connorwhite-online/grip/generative/README.md

# GRIP, redesigned generatively

Every structural link of the arm, grown from its joint layout by
[loadpath](https://github.com/connorwhite-online/loadpath), an open-source
topology optimization engine for printed parts, and sized together as one
chain. GRIP is loadpath's reference project: its CONTEXT.md describes how the
two are developed together.

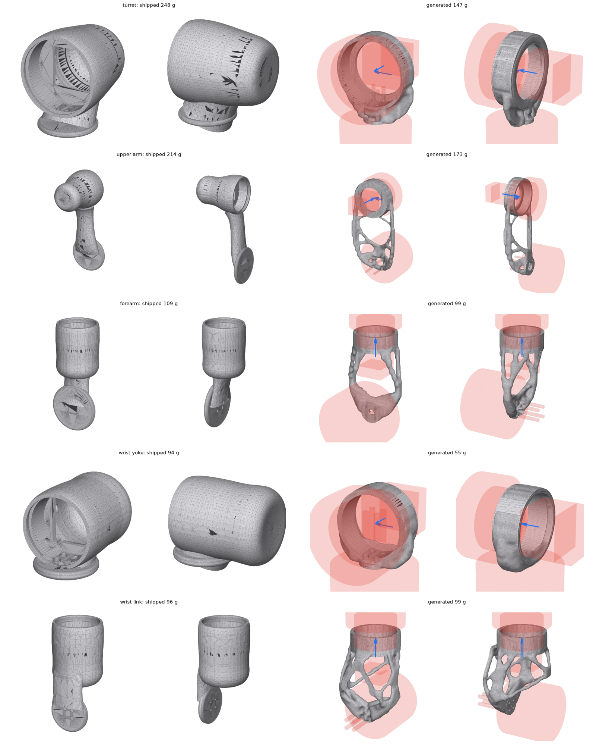
[picture p3: generative/renders/compare.png]
Shipped links (left) and generated links (right)


## What it does

`chain.py` reads the joint layout from `cad/grip_cad/params.py`. For each link it
writes a loadpath study with only the parts of the link that are not negotiable:

- **Preserved:** a bolt ring on the output flange of the joint below, and a socket
  for the drive of the joint above. The socket is a 5 mm sleeve round the housing
  plus the ledge its six M3 inserts sit in.
- **Kept out:** the drives, the motors and their CAN driver boards, the hex-driver
  access to every hub bolt, and room for the next link to swing.

Everything between the hub and the socket is the optimizer's.

Loads come from statics over `urdf/grip.urdf`. Each link carries everything past
it: the links, drives, gripper and a 1 kg payload, with the arm reaching out
horizontally and a 1.5x dynamic factor. Each link also sees the joint above
at its rated torque (the URDF effort), plus a 20 N push along that joint's axis.

The goal is a safety factor of 2 in SLS PA12-GF, as light as possible. After a
pass, the new link masses go back into the statics and the links are optimized
again.

```bash
pip install loadpath            # or put materialize/cad-runner on PYTHONPATH
python generative/chain.py studies                 # write studies/*.json
python generative/chain.py run --iterations 2      # optimize every link, feed masses back
python generative/chain.py report                  # shipped vs generated, same loads
```

## Results (two iterations)

Every part below was verified by a fresh FEA of the delivered mesh under the same
three load cases. Deflection is in mm at the joint above. SF is against 48 MPa,
with a 1.15 allowance.

| Link | Shipped | Generated | SF shipped → generated | Reach deflection | Rated-torque deflection | Side-push deflection |
| --- | --- | --- | --- | --- | --- | --- |
| Turret | 248 g | **147 g** | 1.37 → 1.44 | 0.82 → 0.73 | 0.93 → 0.82 | 0.25 → 0.09 |
| Upper arm | 214 g | **173 g** | 0.50 → 3.89 | 2.69 → 0.70 | 2.05 → 0.25 | 4.42 → 1.35 |
| Forearm | 109 g | **99 g** | 0.51 → 4.09 | 1.81 → 0.21 | 0.14 → 0.05 | 0.39 → 0.03 |
| Wrist yoke | 94 g | **55 g** | 2.33 → 2.73 | 0.50 → 0.32 | 0.25 → 0.16 | 0.03 → 0.03 |
| Wrist link | 96 g | 99 g | 0.48 → 3.42 | 0.75 → 0.17 | 0.95 → 0.11 | 0.94 → 0.16 |
| **Total** | **761 g** | **572 g (−25%)** | | | | |

Every generated link is stiffer than the shipped one in every load case, and
four of the five are lighter. The upper arm, forearm and wrist link go from
breaking at their joint's rated torque (SF ≈ 0.5) to safety factors of 3.4–4.1.

## What it does not change, yet

- **Joint torques barely move.** At J2 the static torque goes from 14.7 to
  14.5 N·m, because the printed links are a small share of what J2 carries:
  about 2.1 kg of motors, gearboxes, bearings and gripper, against about 0.5 kg
  of printed links past J2. Lighter links alone will not let J2 step down from the NEMA 23. That
  takes moving mass out of the wrist, for example by driving J4–J6 from the
  forearm or elbow through belts or cables. That is the next study: the
  structure is no longer the constraint.
- **The motor pods are gone.** The shipped links enclose each motor and
  driver; the generated ones only carry them. Covers would need to be added
  back as thin non-structural shells, about 10–20 g a link, if the
  protection or look matters.
- **Resolution.** These ran at about 3 mm voxels, so members are at least
  about 4.5 mm. Finer runs should take more off. The turret's safety factor
  of 1.44 is under the goal of 2 in the finer verification; the study's own
  check passed it at its resolution.
- **Assumptions to check against the real assembly:** the bolt ring size,
  the 5 mm socket sleeve, the swing clearances and the cable run. FDM parts
  would need a run with PETG and the build direction set.

Generated with loadpath's eval harness; the studies in `studies/` are plain JSON
and can be re-run or edited by hand or by an agent.

## v0.3: a cheaper arm, not just lighter links (`v3.py`)

The v0.2 links showed the structure was no longer the problem: J2 carries
about 2.1 kg of motors and gearboxes, so lighter plastic barely moved its torque.
`architecture.py` compares six layouts against that. v0.3 is option F:

- **J1–J3 stay steppers on printed cycloidal drives, all the same NEMA 17 drive.**
  The NEMA 23 at J2 goes.
- **A spring counterbalances J2.** A zero-free-length spring (cable over a
  pulley on the turret to a pin on the upper arm) cancels most of gravity's
  moment at every angle. J2 then needs 8.4 N·m against the drive's 13 N·m.
- **The wrist and gripper are serial bus servos** (Feetech STS3215/STS3250)
  instead of steppers, gearboxes and driver boards. That takes about 0.9 kg off
  the end of the arm, which is what made the J2 change possible.

Every link was then regenerated around the new hardware: servo cradles,
horn hubs and the spring's pulley, anchor and pin.

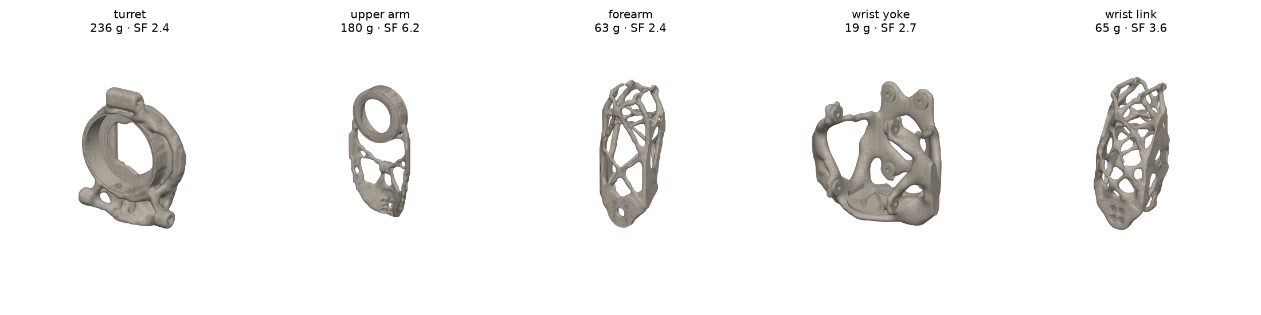
[picture p4: generative/renders/v3.png]
v0.3 links


| Link | Shipped | v0.2 | v0.3 | v0.3 SF |
| --- | --- | --- | --- | --- |
| Turret | 248 g | 147 g | 236 g | 2.41 |
| Upper arm | 214 g | 173 g | 179 g | 2.81 |
| Forearm | 109 g | 99 g | 63 g | 2.39 |
| Wrist yoke | 94 g | 55 g | 19 g | 2.70 |
| Wrist link | 96 g | 99 g | 65 g | 3.55 |
| **Total** | **761 g** | **572 g** | **562 g (-26%)** | |

The turret gains mass because it now carries the spring's pulley and anchor, and because it is now checked on a finer grid (it read SF 2.26 at 60k cells and 1.65 at 120k before).
On the parts that change, the BOM drops about $16 (≈ $209 → $193): one NEMA 23
and its driver, and three stepper/gearbox/driver sets at the wrist, against
three bus servos, a servo driver board, a spring and a pulley.

```bash
python generative/v3.py studies     # write v3/studies/*.json
python generative/v3.py run --jobs 3
```

Open items before printing:

- **Servo dimensions and shaft offsets are marked VERIFY in `v3.py`**; they are
  from datasheets, not calipers.
- **J5 torque:** the STS3250 is rated about 1.6 N·m continuous; J5 needs about
  1.7 N·m at a 1 kg payload at full reach. It is fine for 0.5 kg; at 1 kg it is
  a peak, not a continuous, load.
- **Servo holders** are fixed only where the servo is held: a collar round the
  body at the horn end (where its ears screw down) and a pad under the far end.
  The walls between are generated. (A full 3 mm box was most of the wrist yoke.)
- The spring rate and anchor geometry (k = 1 N/mm, a = 62 mm, b = 80 mm) are
  sized for the arm at rest. Check them against the assembled arm's real mass.

### Simulations

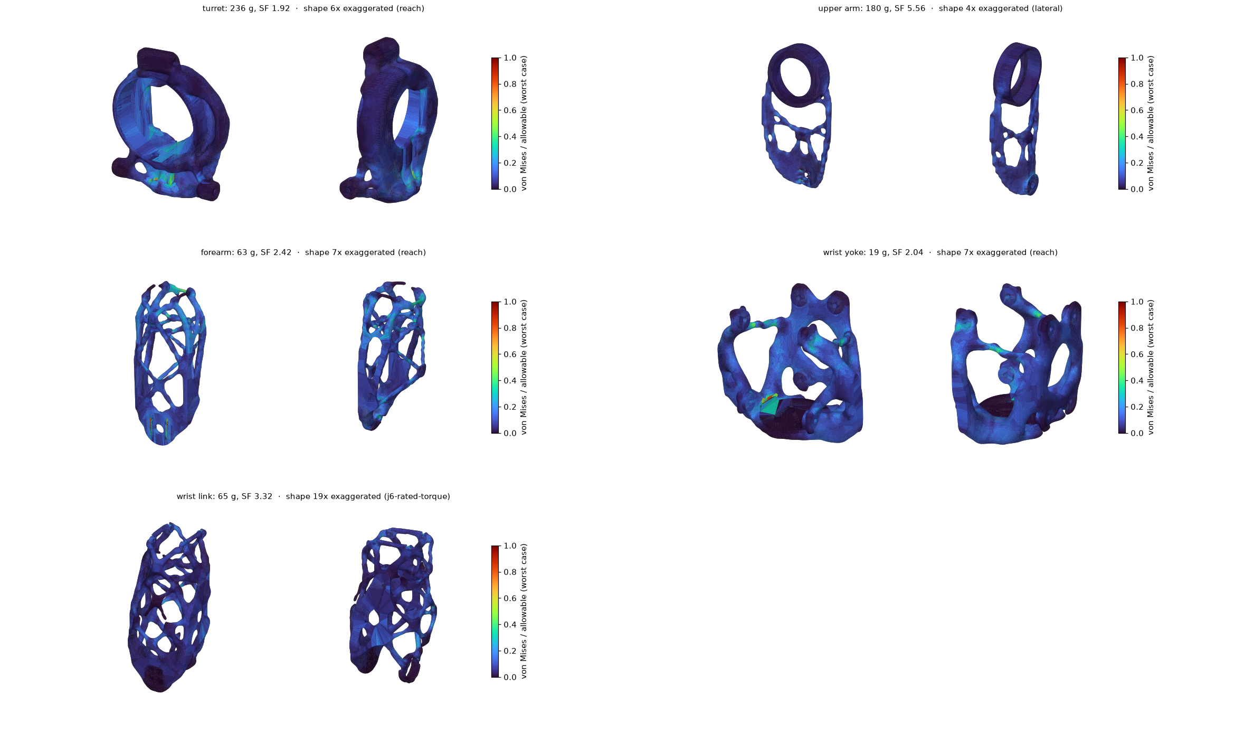
[picture p5: generative/renders/sims.png]
Stress maps


`sims.py` re-checks each delivered part on a finer grid (120k cells) and
colours it by the worst case's stress over the allowable at SF 2, on the shape
deflected and exaggerated. Results are in `v3/out/sims.json`.

| Link | SF (finer check) | Worst deflection |
| --- | --- | --- |
| Turret | 1.92 | 0.54 mm (reach) |
| Upper arm | 5.56 | 1.55 mm (lateral) |
| Forearm | 2.42 | 0.45 mm (reach) |
| Wrist yoke | 2.04 | 0.14 mm (reach) |
| Wrist link | 3.32 | 0.20 mm (reach) |

Every search now re-checks its pick on a 150k-cell grid before delivering it
(loadpath's confirm stage), and material carrying no load is pruned. The
checks on different grids still differ by about ±20% at small fillets: the
turret reads 2.41 at 150k cells and 1.92 here.
## The hand (`hand.py`)

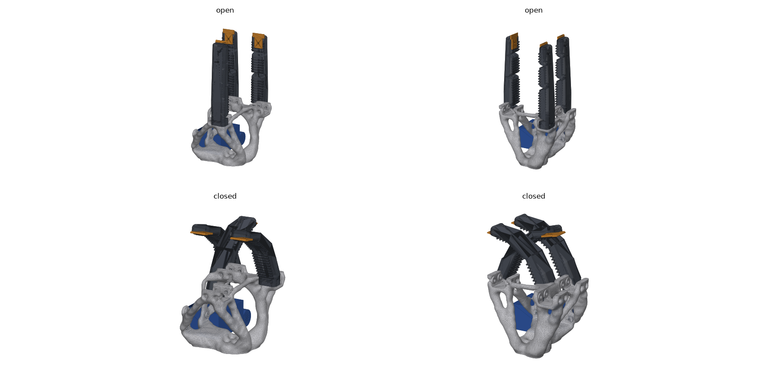
[picture p6: generative/renders/hand.png]
Three-finger hand, open and closed


Three soft fingers on one servo replace the parallel-jaw gripper and its
two Ø6 rods, four LM6UU bearings, rack, pinion and set screws.

- **Fingers:** one TPU print each (20 g): three phalanges on flexure hinges,
  a tendon channel, ridged pads, tapered and rounded. About 17 N of tendon
  closes them; the rest is grip.
- **One servo, one tendon, a balance plate:** the STS3215 winds a spool; a
  floating three-way plate splits the pull so each finger stops when it
  touches and the others keep closing.
- **Optional fingernails** for flat parts on a print bed: a PA12 blade with a
  15 mm tongue down the last phalanx, seated on a shoulder (scraping pushes
  it in) and held by an M2 screw through the finger (prying and pull-out).
- **Palm:** generated, 56 g, SF 3.2 under the grasp, a 1 kg pull-out, a side
  load, and the tendon at half the servo's stall torque.

Grip force at 60 N of tendon (1.4 N·m on the servo) is about 4 to 28 N per
finger, depending on where the part touches. The servo reports its load, so
the arm can grip by force without a sensor. All of it is a first concept:
VERIFY the flexure thickness on a printed coupon, the servo, and the tendon
routing.

### Can the optimizer design the finger? (`finger_mechanism.py`, experimental)

A finger has to bend, so it is a compliant-mechanism problem, not a
stiffness one; loadpath gained a mechanism optimizer for it
(`loadpath.mechanism`, Sigmund's formulation with MMA). Two framings so far:

- **Tendon curl** (maximize the pad's inward travel when the tendon pulls)
  comes out as a single leaf spring: the honest optimum of that question, and
  not a useful finger.
- **Fin-ray wrap** (an object pressing the middle of the palm face should
  swing the tip in toward it) needs a deep root to lever with. At 28 mm it
  finds the fin ray's principle, a strut leaning from the back of the root
  up to the palm skin, but only one rib of it.

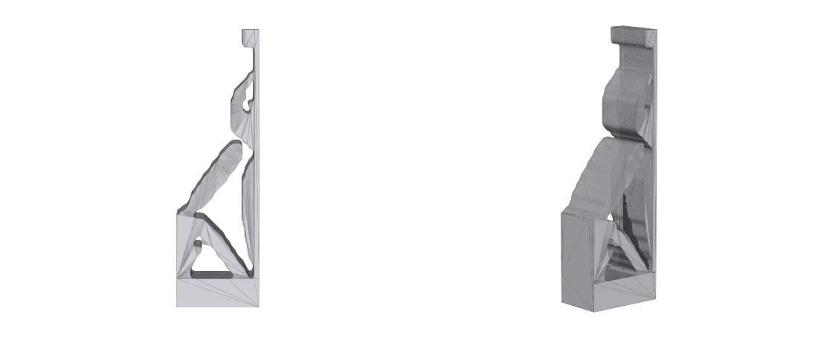
[picture p7: generative/renders/finger-wrap.png]
Fin-ray wrap, first result


Next: contact anywhere along the finger (several input cases at once, which
is what makes a real fin ray grow its ladder of ribs), and large-deflection
checks. Until then the hinged finger in `hand.py` is the design.
