connorwhite-online/grip/docs/img/exploded_j2.png

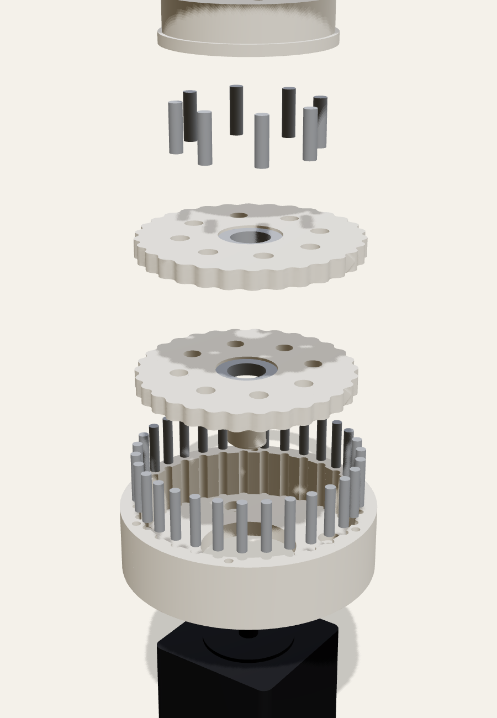
docs/img/exploded_j2.png
