connorwhite-online/grip/docs/img/exploded_wrist.png

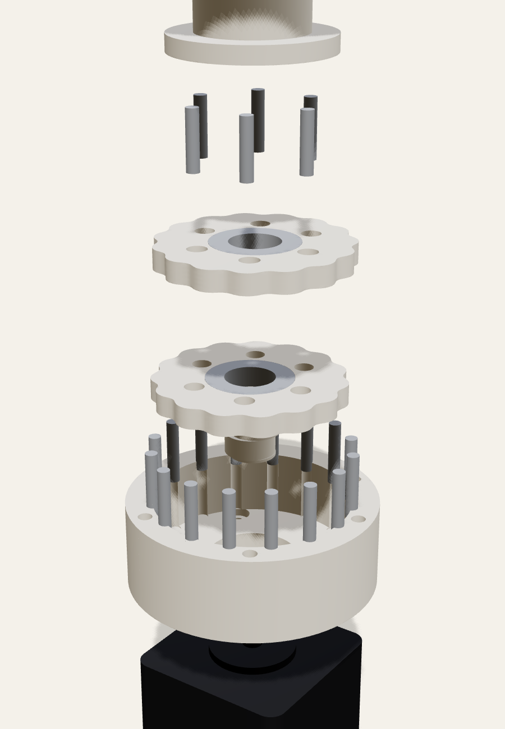
docs/img/exploded_wrist.png
