connorwhite-online/grip/docs/img/home_front.png

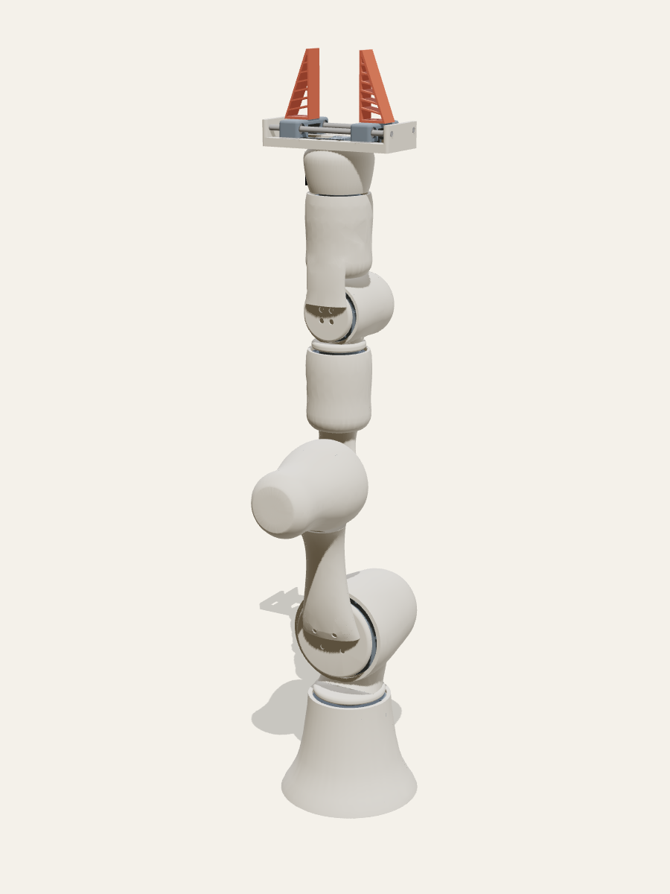
docs/img/home_front.png
