connorwhite-online/grip/docs/img/home_side.png

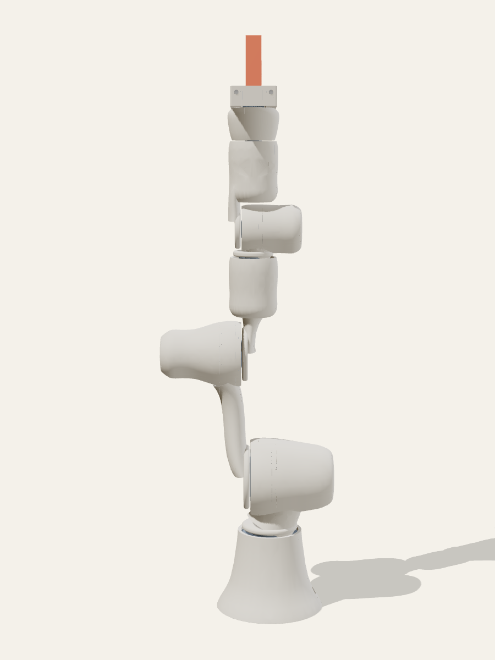
docs/img/home_side.png
