connorwhite-online/grip/docs/img/reach_pose.png

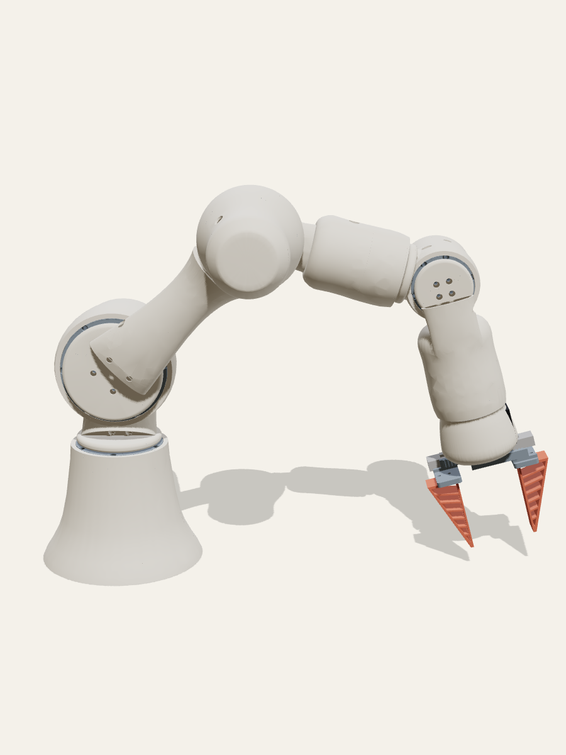
docs/img/reach_pose.png
