connorwhite-online/grip/generative/renders/sim-forearm.png

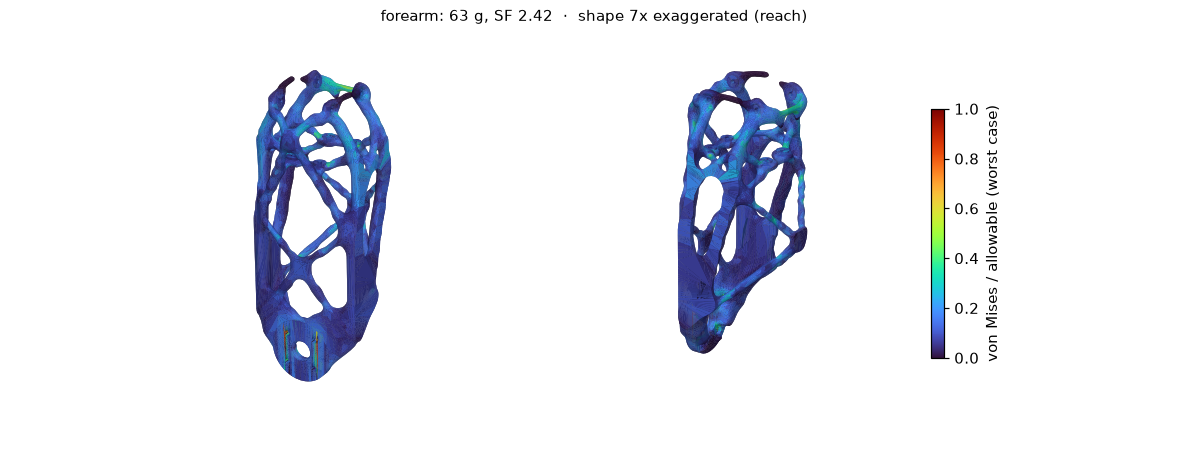
generative/renders/sim-forearm.png
