connorwhite-online/grip/generative/renders/sim-turret.png

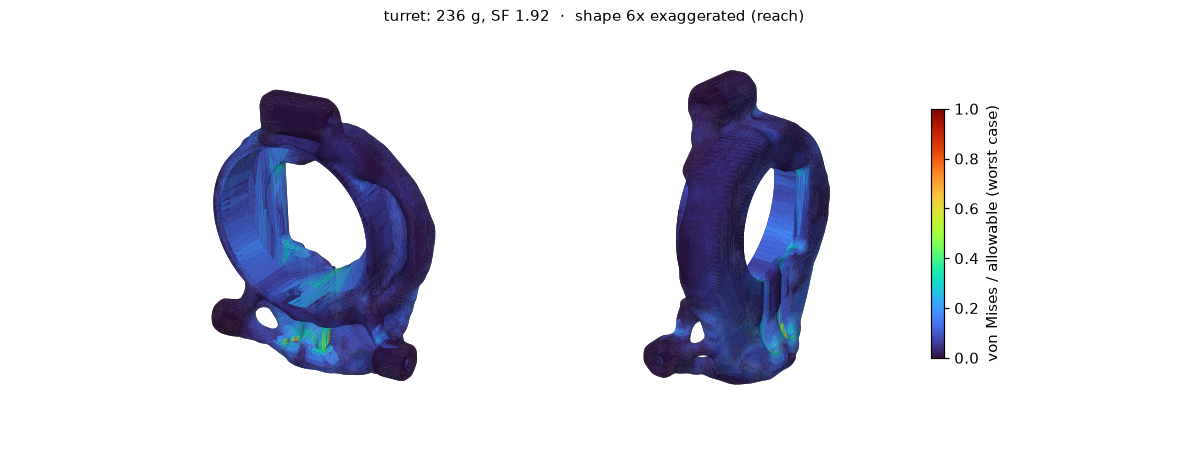
generative/renders/sim-turret.png
