connorwhite-online/grip/generative/renders/sim-wrist_yoke.png

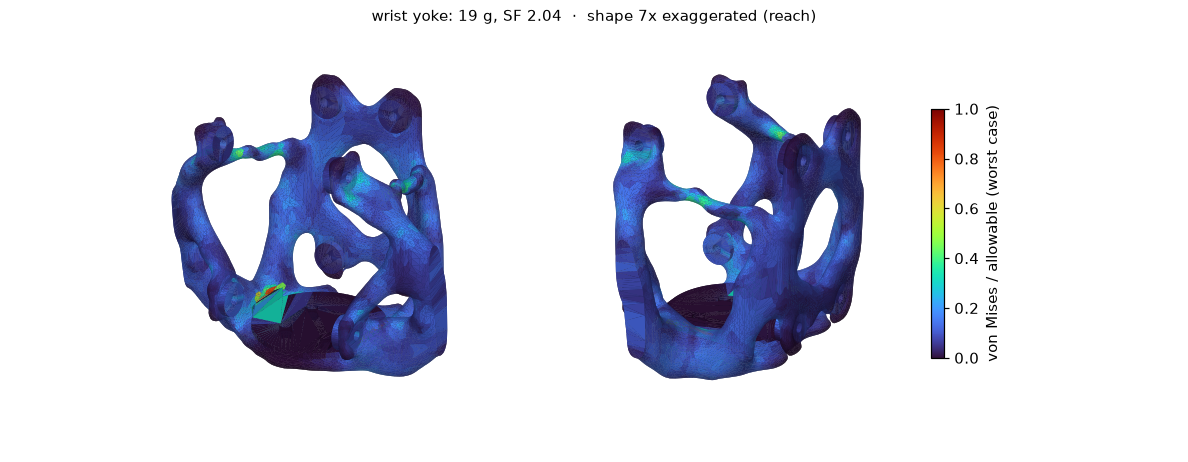
generative/renders/sim-wrist_yoke.png
