connorwhite-online/grip/bom/BOM.md

# GRIP bill of materials

Bought parts for version B; the same list serves both the SLS and the FDM edition. Prices marked *estimate* could not be read from the store page (Amazon and AliExpress block automated reads); check them when ordering. Printed parts are listed after.

## Motion

| Item | Spec | Qty | Unit (USD) | Line (USD) | Price | Buy |
| --- | --- | ---: | ---: | ---: | --- | --- |
| Stepper J2 shoulder | NEMA 23, 1.26 Nm, 56 mm, dual shaft Ø8 (23HS22-2804D) | 1 | 17.68 | 17.68 | checked 2026-10-27 | [StepperOnline](https://www.omc-stepperonline.com/dual-shaft-nema-23-bipolar-126nm-1784ozin-28a-25v-57x57x56mm-4-wires-23hs22-2804d.html) |
| Stepper J1 base + J3 elbow | NEMA 17, 0.65 Nm, 60 mm, dual shaft Ø5 (17HS24-2104D) | 2 | 13.05 | 26.10 | checked 2026-10-27 | [StepperOnline](https://www.omc-stepperonline.com/Dual-Shaft-Nema-17-Bipolar-18deg-65Ncm-923ozin-210A-336V-42x42x60mm-4-Wires.html) |
| Stepper J4-J6 wrist | NEMA 17, 0.26 Nm, 34 mm, dual shaft Ø5 (17HS13-0404D) | 3 | 8.75 | 26.25 | checked 2026-10-27 | [StepperOnline](https://www.omc-stepperonline.com/dual-shaft-nema-17-bipolar-1-8deg-26ncm-36-8oz-in-0-4a-12v-42x34mm-4-wires-17hs13-0404d) |
| Closed-loop driver NEMA 17 | MKS SERVO42D, CAN version (magnet on rear shaft) | 5 | 28.00 | 140.00 | estimate | [Makerbase (AliExpress)](https://www.aliexpress.com/item/1005005593922187.html) |
| Closed-loop driver NEMA 23 | MKS SERVO57D, CAN version | 1 | 40.00 | 40.00 | estimate | [Makerbase (AliExpress)](https://www.aliexpress.com/item/1005005389508166.html) |

Subtotal: **$250.03**

## Gripper

| Item | Spec | Qty | Unit (USD) | Line (USD) | Price | Buy |
| --- | --- | ---: | ---: | ---: | --- | --- |
| Gripper servo | Feetech STS3215, 12 V, 30 kg·cm, magnetic encoder | 1 | 29.00 | 29.00 | checked 2026-10-27 (EUR 26.51) | [OpenELAB](https://openelab.io/collections/feetech-motor) |
| Bus servo adapter | Waveshare Bus Servo Adapter (A), USB to TTL bus | 1 | 4.99 | 4.99 | checked 2026-10-27 | [Waveshare](https://www.waveshare.com/bus-servo-adapter-a.htm) |
| Guide rods | Ø6 x 150 mm hardened linear shaft (2) | 1 | 8.00 | 8.00 | estimate | [Amazon](https://www.amazon.com/s?k=6mm+x+150mm+linear+shaft) |
| Linear bearings | LM6UU, Ø6 x 12 x 19 (4 used, pack of 10) | 1 | 7.00 | 7.00 | estimate | [Amazon](https://www.amazon.com/s?k=lm6uu+linear+bearing+10+pack) |

Subtotal: **$48.99**

## Gearbox

| Item | Spec | Qty | Unit (USD) | Line (USD) | Price | Buy |
| --- | --- | ---: | ---: | ---: | --- | --- |
| Output bearing J2 | 6812-2RS, 60x78x10 (uxcell) | 1 | 11.49 | 11.49 | checked 2026-10-27 | [Walmart](https://www.walmart.com/ip/Uxcell-60x78x10mm-6812-2RS-Double-Sealed-Ball-Bearings-Chrome-Steel/867130943) |
| Output bearing J1/J3 | 6808-2RS, 40x52x7 | 2 | 9.99 | 19.98 | checked 2026-10-27 | [Walmart](https://www.walmart.com/ip/6808-2RS-Deep-Groove-Ball-Bearing-40x52x7mm-Double-Sealed-Chrome-Steel-Bearing/631340571) |
| Output bearing wrist | 6805-2RS, 25x37x7 (generic pack of 4-5; 3 used) | 1 | 14.00 | 14.00 | estimate (VXB singles $7.77 checked) | [Amazon](https://www.amazon.com/s?k=6805-2rs+bearing) |
| Eccentric bearing J2 | 6802-2RS, 15x24x5 (generic 10-pack; 2 used) | 1 | 9.00 | 9.00 | estimate (VXB singles $7.77 checked) | [Amazon](https://www.amazon.com/s?k=6802-2rs+bearing+10+pack) |
| Eccentric bearing J1/J3/wrist | 6801-2RS, 12x21x5 (generic 10-pack; 10 used) | 1 | 10.00 | 10.00 | estimate (VXB 10-pack $29.99 checked) | [Amazon](https://www.amazon.com/s?k=6801-2rs+bearing+10+pack) |
| Ring pins J1/J2/J3 | Dowel pin Ø4 x 20 mm, steel (83 needed) | 90 | 0.12 | 10.80 | estimate | [Amazon (uxcell packs)](https://www.amazon.com/stainless-steel-dowel-pins/s?k=stainless+steel+dowel+pins+4mm+x+20mm) |
| Ring pins wrist | Dowel pin Ø3 x 16 mm, steel (48 needed) | 50 | 0.10 | 5.00 | estimate | [Amazon (uxcell packs)](https://www.amazon.com/stainless-steel-dowel-pins/s?k=stainless+steel+dowel+pins+3mm+x+16mm) |
| Output pins J2 | Dowel pin Ø5 x 18 mm, steel | 8 | 0.20 | 1.60 | estimate | [Amazon (uxcell packs)](https://www.amazon.com/stainless-steel-dowel-pins/s?k=stainless+steel+dowel+pins+5mm+x+18mm) |
| Output pins J1/J3 | Dowel pin Ø4 x 16 mm, steel | 12 | 0.12 | 1.44 | estimate | [Amazon (uxcell packs)](https://www.amazon.com/stainless-steel-dowel-pins/s?k=stainless+steel+dowel+pins+4mm+x+16mm) |
| Output pins wrist | Dowel pin Ø3 x 14 mm, steel | 18 | 0.10 | 1.80 | estimate | [Amazon (uxcell packs)](https://www.amazon.com/stainless-steel-dowel-pins/s?k=stainless+steel+dowel+pins+3mm+x+14mm) |

Subtotal: **$85.11**

## Fasteners

| Item | Spec | Qty | Unit (USD) | Line (USD) | Price | Buy |
| --- | --- | ---: | ---: | ---: | --- | --- |
| Heat-set inserts | M3 x 5.7 brass (pack of 100; 66 used), plus 3x M5 | 1 | 12.00 | 12.00 | estimate | [Amazon](https://www.amazon.com/s?k=m3+heat+set+inserts) |
| Socket head screws | M3x8 (24) for the link hubs, plus gearbox through-bolts M3x40 (6), M3x35 (12), M3x30 (18) | 1 | 18.00 | 18.00 | estimate | [Amazon](https://www.amazon.com/s?k=m3+socket+head+screw+assortment) |
| Motor screws | Low-head DIN 7984: M3x8 (20) for the NEMA 17s, M5x16 + M5 nyloc nut (4) for the NEMA 23 | 1 | 8.00 | 8.00 | estimate | [Amazon](https://www.amazon.com/s?k=din+7984+m3+low+head+socket+screw) |
| Base and gripper screws | M5x20 (3) base to table; M3x12 (4) gripper frame to palm; M3x10 + nyloc (4) fingers; M3x6 set screw (4) guide rods; M3x12 (2) camera cradle; M2x5 self-tapping (4) camera board | 1 | 7.00 | 7.00 | estimate | [Amazon](https://www.amazon.com/s?k=m2+socket+head+screw+assortment) |

Subtotal: **$45.00**

## Electronics

| Item | Spec | Qty | Unit (USD) | Line (USD) | Price | Buy |
| --- | --- | ---: | ---: | ---: | --- | --- |
| USB to CAN adapter | CANable 2.0 clone (candleLight firmware, SocketCAN) | 1 | 15.00 | 15.00 | estimate | [AliExpress](https://www.aliexpress.com/w/wholesale-canable-2.0.html) |
| Power supply | 24 V 10 A enclosed switching supply (generic; Mean Well LRS-250-24 if you want the name brand) | 1 | 20.00 | 20.00 | estimate | [Amazon](https://www.amazon.com/s?k=24v+10a+switching+power+supply) |
| Buck converter | 24 V to 12 V 5 A for the gripper servo | 1 | 6.00 | 6.00 | estimate | [Amazon](https://www.amazon.com/s?k=24v+to+12v+5a+buck+converter) |
| Emergency stop | Latching mushroom e-stop, NC, cuts motor power | 1 | 7.00 | 7.00 | estimate | [Amazon](https://www.amazon.com/s?k=emergency+stop+button+latching) |
| Wiring | 20 AWG silicone wire (22 AWG from J4 up), twisted pair for CAN, XT30 connectors, inline fuse | 1 | 15.00 | 15.00 | estimate | [Amazon](https://www.amazon.com/s?k=20+awg+silicone+wire) |

Subtotal: **$63.00**

## Vision

| Item | Spec | Qty | Unit (USD) | Line (USD) | Price | Buy |
| --- | --- | ---: | ---: | ---: | --- | --- |
| Wrist camera | Arducam UB0234: OV2710 1080p USB 2.0 UVC board, 32 x 32 mm, M12 lens 105 deg horizontal | 1 | 34.99 | 34.99 | checked 2026-10-27 | [Arducam](https://www.arducam.com/arducam-2mp-wide-angle-usb2-0-camera-board-with-m12-lens-1-2-7-cmos-ov2710-uvc-usb-webcam-without-microphone-for-computer-laptop-android-devi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) |
| Camera cable | Slim USB 2.0 cable, 2 m, 3 mm OD or less (spliced to the camera's lead, see docs/VISION.md) | 1 | 6.00 | 6.00 | estimate | [Amazon](https://www.amazon.com/s?k=slim+thin+usb+2.0+cable+2m) |
| Camera light | 5 V white LED strip, 2835, 60 LED/m, 8 mm wide (two 2-LED pieces beside the lens) | 1 | 6.00 | 6.00 | estimate | [Amazon](https://www.amazon.com/s?k=5v+usb+led+strip+2835+white+8mm) |
| Fiducial markers | AprilTag tag36h11 printed on matte sticker paper (id 0 on the bed; id 1 optional), plus a ChArUco board for camera calibration | 1 | 0.00 | 0.00 | print yourself | [AprilRobotics](https://github.com/AprilRobotics/apriltag-imgs) |

Subtotal: **$46.99**

**Bought parts total: $539.12**

## Printed parts

30 unique parts, 50 pieces, 1,620 cm³ in total. Full list with materials in [exports/printed_parts.csv](../exports/printed_parts.csv); bureau stacked kits in [exports/service_kits.csv](../exports/service_kits.csv).

## Printed parts, FDM edition

Filament for one arm, before supports and failed prints (allow about 15% more). Per-part list in [exports/fdm/printed_parts.csv](../exports/fdm/printed_parts.csv); settings in [docs/FDM.md](../docs/FDM.md).

| Material | Filament |
| --- | ---: |
| FDM PETG | 1.79 kg |
| FDM PETG-CF (or PA-CF) | 0.31 kg |
| FDM TPU 95A | 0.03 kg |
