connorwhite-online/grip/exports/service_kits.csv

kit | qty | material | volume_cm3 | bbox_x_mm | bbox_y_mm | bbox_z_mm | stl
kit_j2_drive | 1 | SLS PA12 | 214.8 | 102.0 | 102.0 | 94.0 | stl/kits/kit_j2_drive.stl
kit_j1_j3_drive | 2 | SLS PA12 | 128.1 | 86.0 | 86.0 | 80.5 | stl/kits/kit_j1_j3_drive.stl
kit_wrist_drive | 3 | SLS PA12 | 57.9 | 61.0 | 61.0 | 74.5 | stl/kits/kit_wrist_drive.stl
kit_gripper | 1 | SLS PA12 | 32.8 | 76.5 | 65.0 | 64.0 | stl/kits/kit_gripper.stl
kit_fingers | 1 | SLS TPU 90A-95A | 21.5 | 30.0 | 22.0 | 146.0 | stl/kits/kit_fingers.stl
