connorwhite-online/grip/exports/step/grip_assembly.step

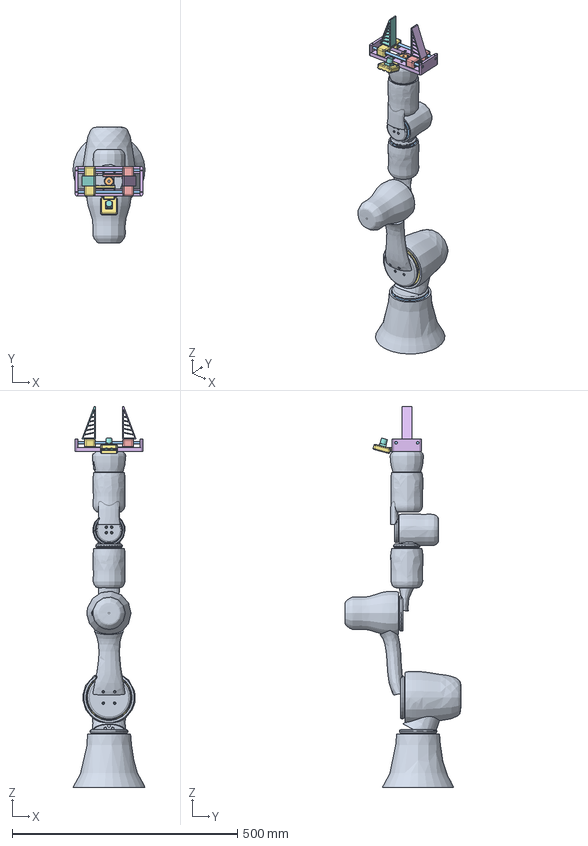
[picture p16: CAD file, 2026-10-28]
exports/step/grip_assembly.step
160.0 x 257.3 x 846.0 mm
base
turret
upper_arm
forearm
wrist_yoke
wrist_link
j1_housing
j1_cap
j1_output_flange
j1_motor
j2_housing
j2_cap
j2_output_flange
j2_motor
j3_housing
j3_cap
j3_output_flange
j3_motor
j4_housing
j4_cap
j4_output_flange
j4_motor
j5_housing
j5_cap
j5_output_flange
j5_motor
j6_housing
j6_cap
j6_output_flange
j6_motor
gripper_palm
gripper_frame
gripper_camera_mount
gripper_camera
gripper_servo
gripper_pinion
gripper_rod_b
gripper_rod_a
gripper_bearings_a
gripper_jaw_a
gripper_finger_a
gripper_bearings_b
gripper_jaw_b
gripper_finger_b
