connorwhite-online/grip/exports/fdm/step/turret.step

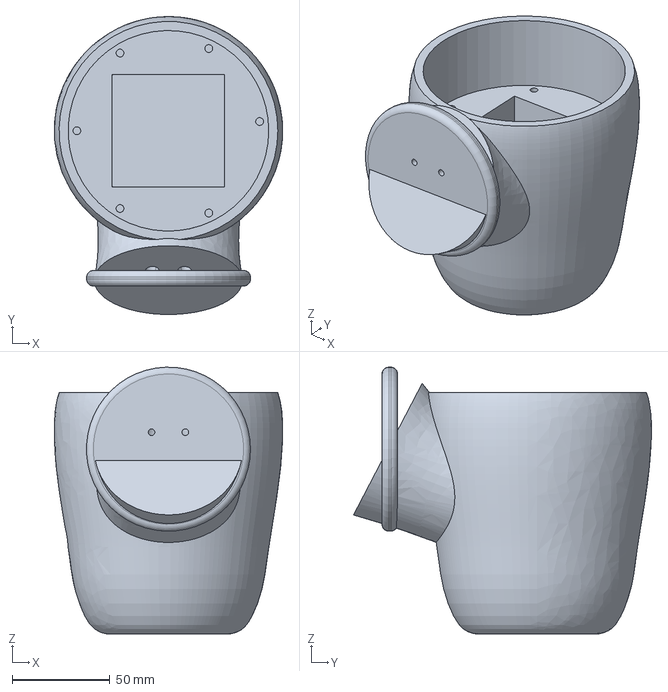
[picture p17: CAD file, 2026-10-28]
exports/fdm/step/turret.step
116.9 x 152.6 x 136.6 mm
