connorwhite-online/grip/exports/step/wrist_drive_eccentric.step

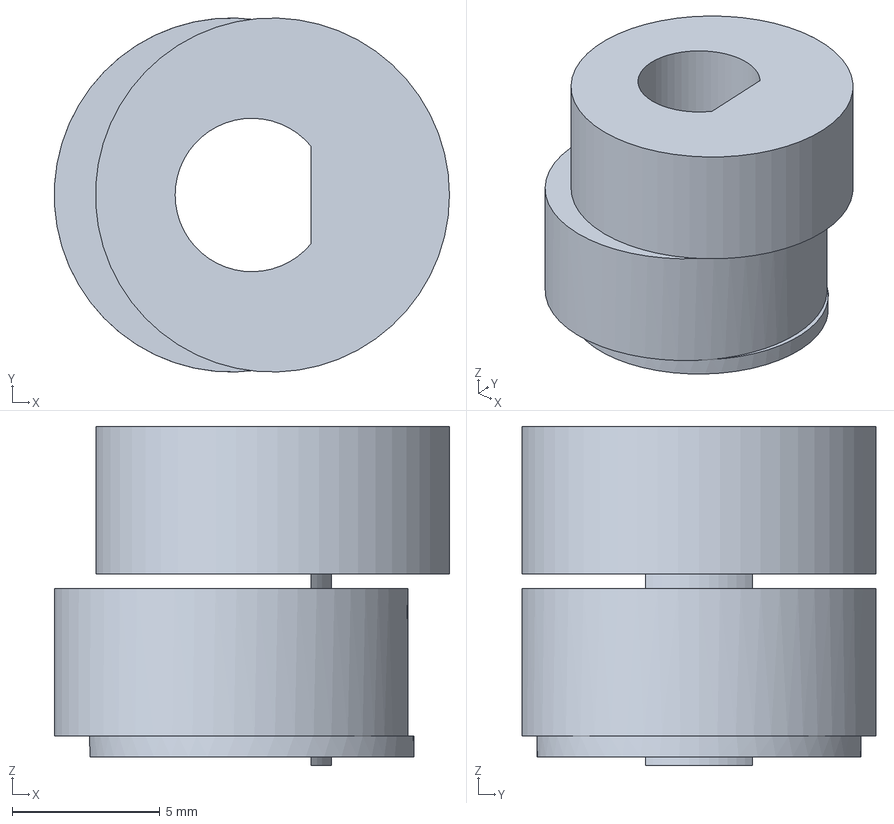
[picture p18: CAD file, 2026-10-28]
exports/step/wrist_drive_eccentric.step
13.4 x 12.0 x 11.5 mm
