connorwhite-online/grip/exports/stl/kits/kit_gripper.stl

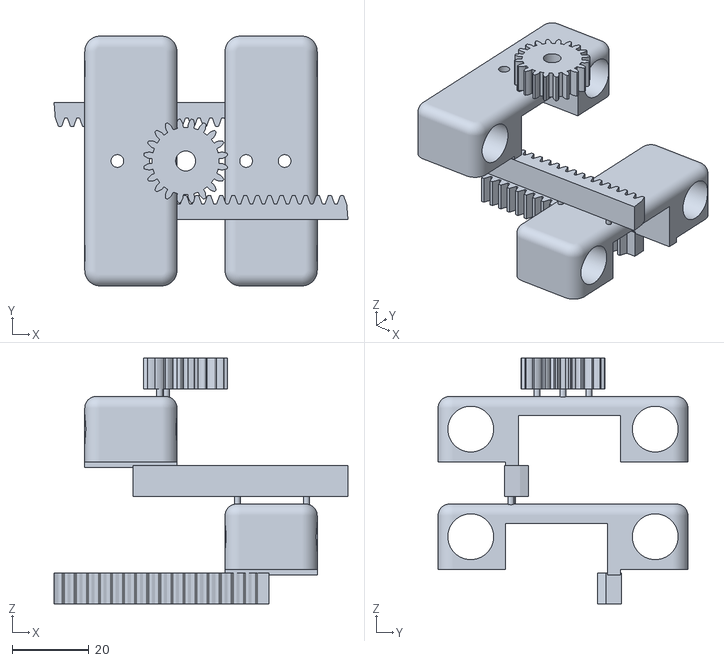
[picture p19: CAD file, 2026-10-27]
exports/stl/kits/kit_gripper.stl
76.5 x 65.0 x 64.0
