connorwhite-online/grip/generative/hand/finger-mech.stl

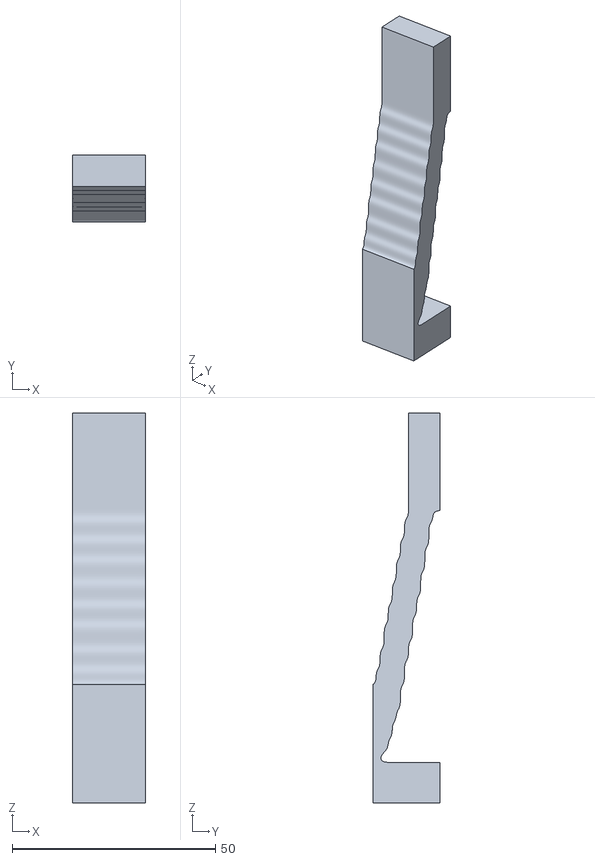
[picture p20: CAD file, 2026-10-29]
generative/hand/finger-mech.stl
18.0 x 16.5 x 96.0
