connorwhite-online/grip/generative/out/wrist_link.stl

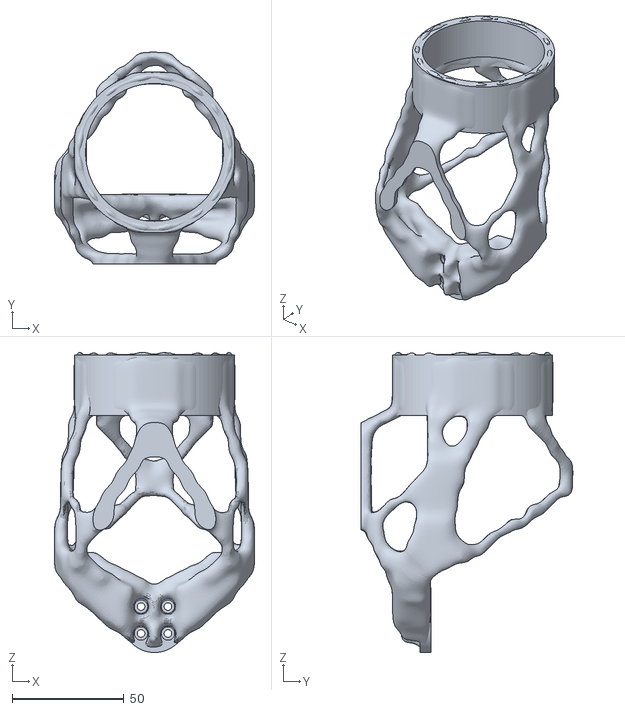
[picture p21: CAD file, 2026-10-29]
generative/out/wrist_link.stl
89.5 x 94.6 x 134.1
