connorwhite-online/grip/generative/print/grip-wrist-yoke-PETG-FDM-v3.stl

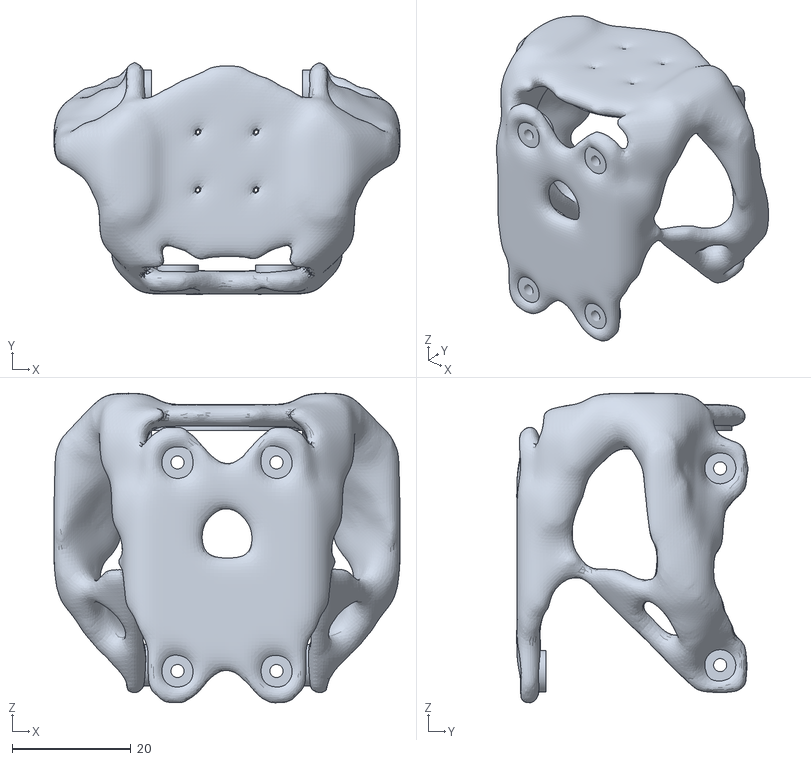
[picture p22: CAD file, 2026-10-29]
generative/print/grip-wrist-yoke-PETG-FDM-v3.stl
58.4 x 39.1 x 52.2
