connorwhite-online/grip/generative/v3/out/turret.stl

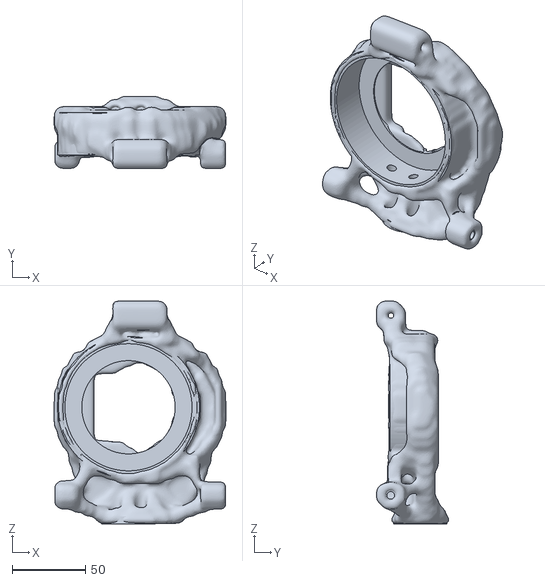
[picture p23: CAD file, 2026-10-29]
generative/v3/out/turret.stl
116.9 x 49.2 x 151.9
