connorwhite-online/grip/urdf/meshes/tool.stl

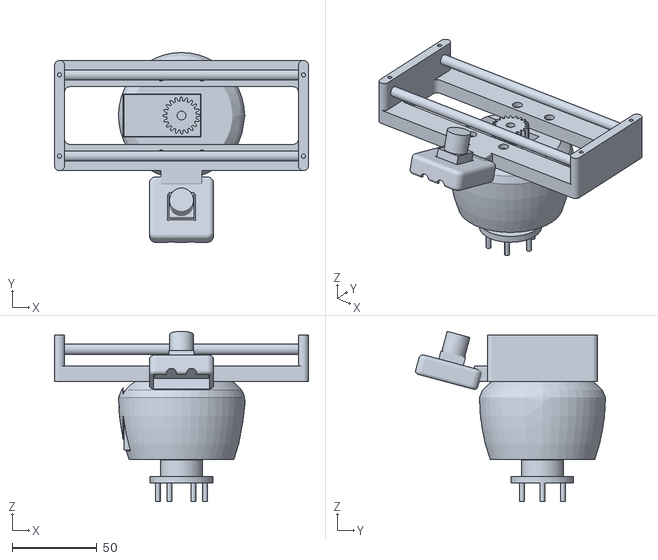
[picture p24: CAD file, 2026-10-28]
urdf/meshes/tool.stl
150.0 x 112.2 x 100.6
