connorwhite-online/grip/exports/fdm/step/j1_j3_drive_output_flange.step

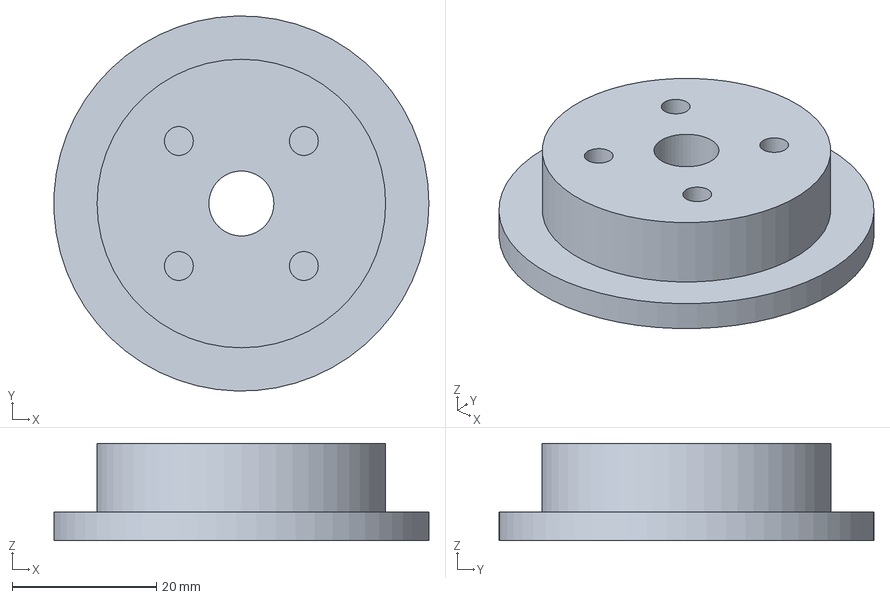
[picture p25: CAD file, 2026-10-28]
exports/fdm/step/j1_j3_drive_output_flange.step
52.0 x 52.0 x 13.5 mm
