connorwhite-online/grip/exports/step/j2_drive_disc_a.step

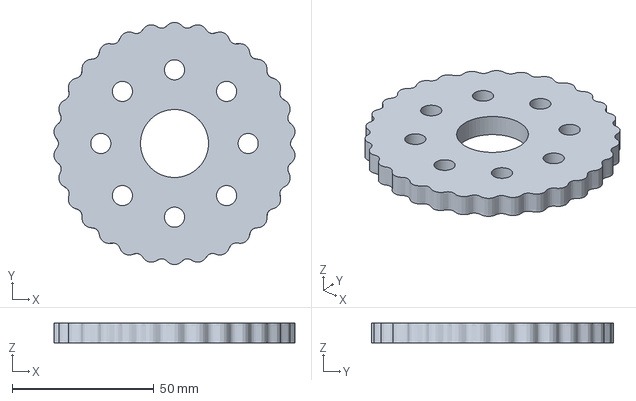
[picture p26: CAD file, 2026-10-28]
exports/step/j2_drive_disc_a.step
85.1 x 85.5 x 7.00 mm
