connorwhite-online/grip/exports/stl/kits/kit_j1_j3_drive.stl

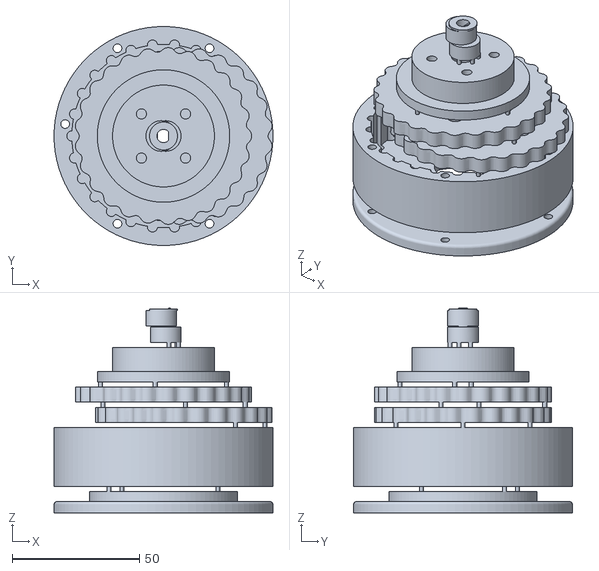
[picture p27: CAD file, 2026-10-27]
exports/stl/kits/kit_j1_j3_drive.stl
86.0 x 86.0 x 80.5
