connorwhite-online/grip/generative/hand/finger.stl

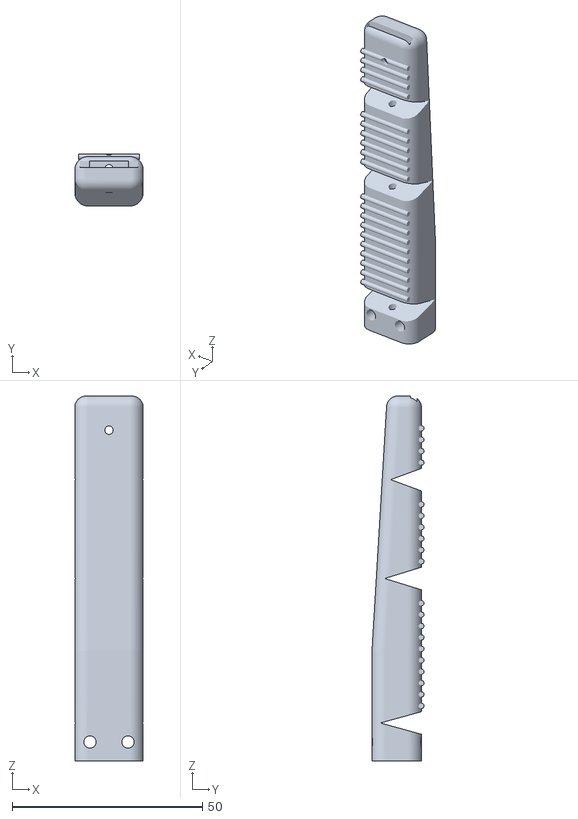
[picture p28: CAD file, 2026-10-29]
generative/hand/finger.stl
18.0 x 13.7 x 96.0
