connorwhite-online/grip/generative/out/upper_arm.stl

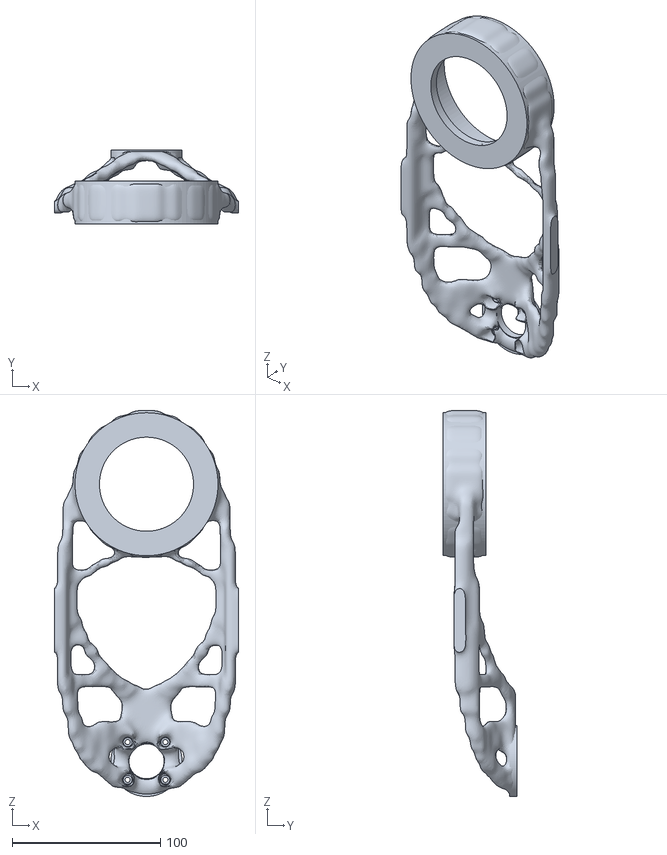
[picture p29: CAD file, 2026-10-29]
generative/out/upper_arm.stl
124.6 x 50.0 x 260.8
