connorwhite-online/grip/generative/v3/out/forearm.stl

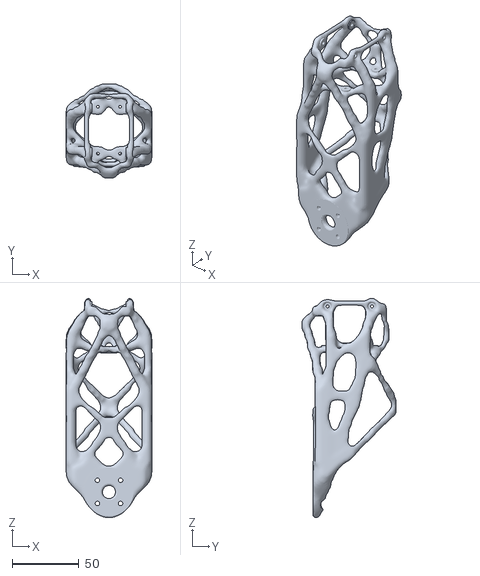
[picture p30: CAD file, 2026-10-29]
generative/v3/out/forearm.stl
64.2 x 70.7 x 164.1
