connorwhite-online/grip/urdf/meshes/forearm.stl

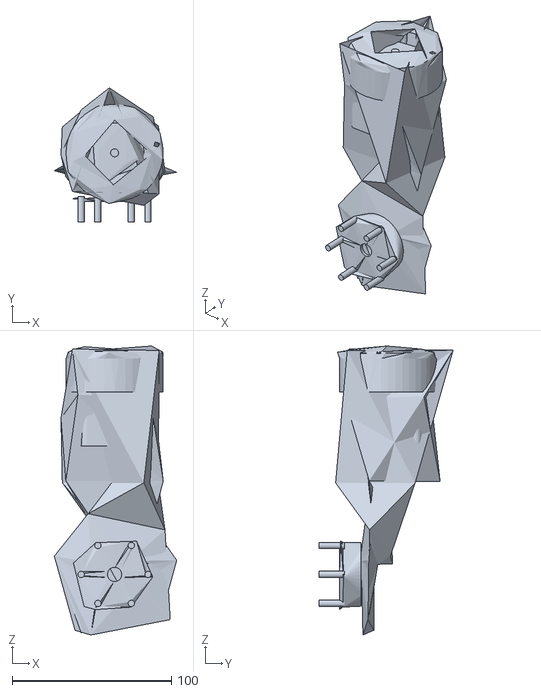
[picture p31: CAD file, 2026-10-27]
urdf/meshes/forearm.stl
76.8 x 84.3 x 181.5
