connorwhite-online/grip/exports/fdm/step/wrist_drive_housing.step

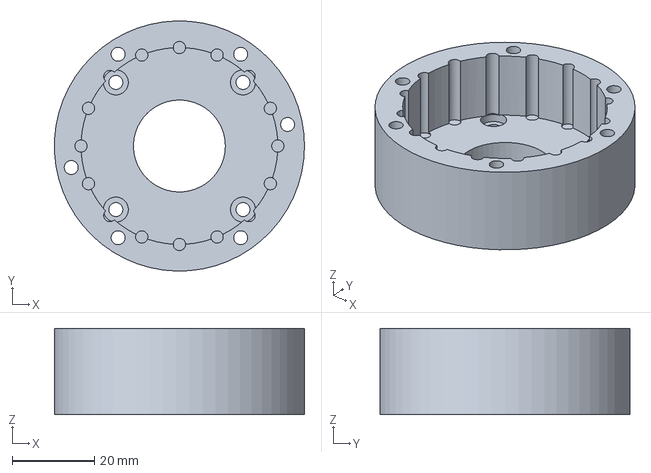
[picture p32: CAD file, 2026-10-28]
exports/fdm/step/wrist_drive_housing.step
61.0 x 61.0 x 21.0 mm
