connorwhite-online/grip/exports/step/j2_drive_output_flange.step

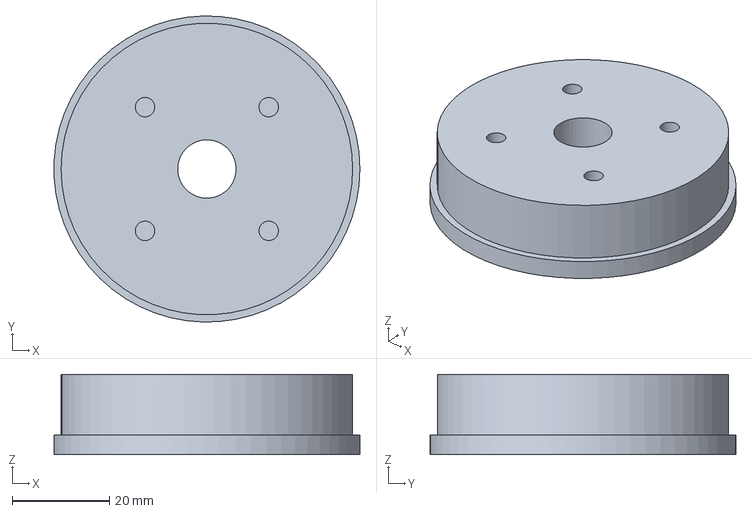
[picture p33: CAD file, 2026-10-28]
exports/step/j2_drive_output_flange.step
63.0 x 63.0 x 16.5 mm
