connorwhite-online/grip/exports/stl/kits/kit_j2_drive.stl

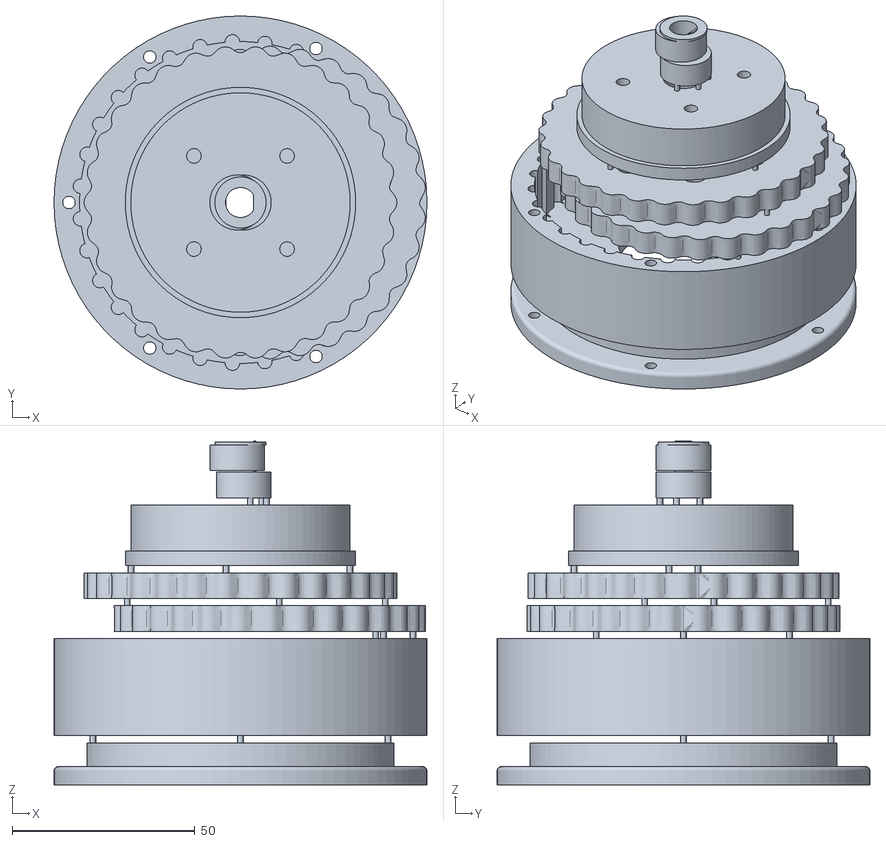
[picture p34: CAD file, 2026-10-27]
exports/stl/kits/kit_j2_drive.stl
102.0 x 102.0 x 94.0
