connorwhite-online/grip/generative/hand/nail.stl

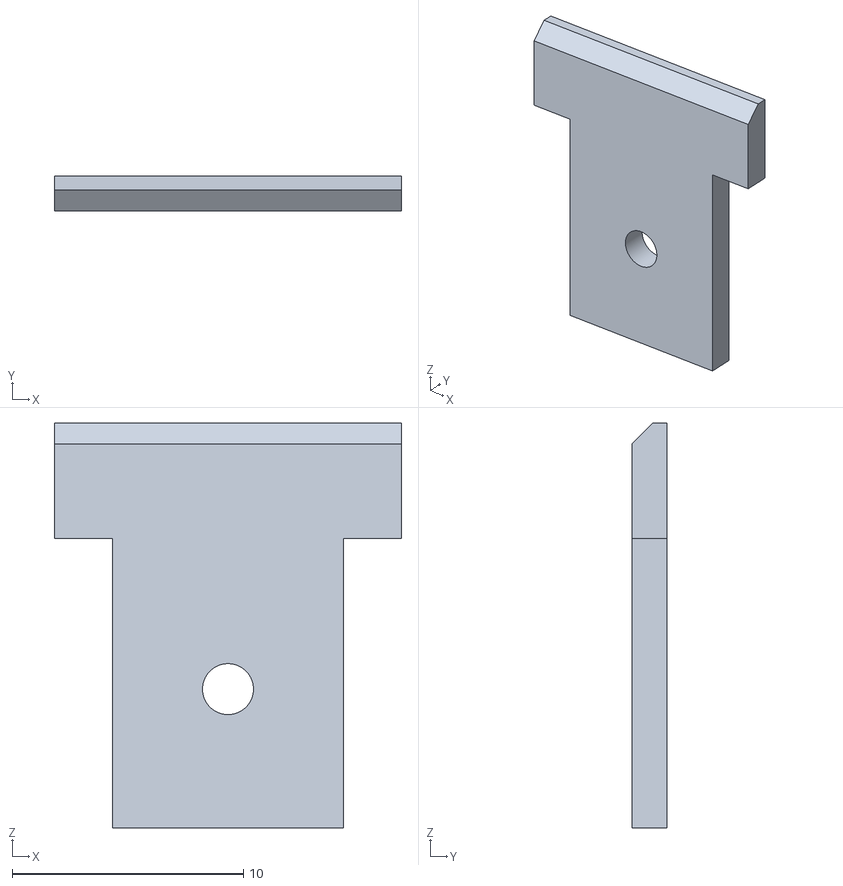
[picture p35: CAD file, 2026-10-29]
generative/hand/nail.stl
15.0 x 1.50 x 17.5
