connorwhite-online/grip/generative/out/turret.stl

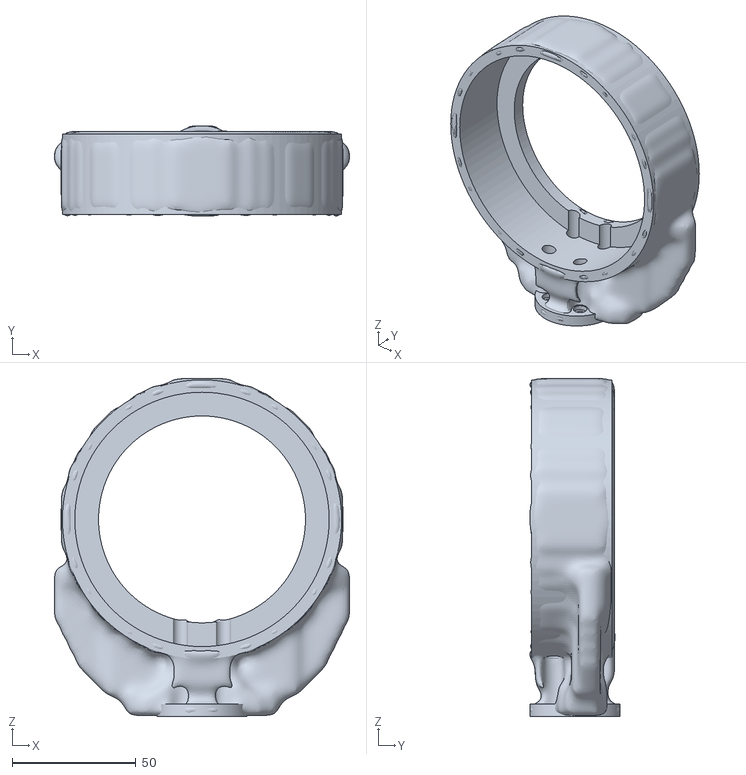
[picture p36: CAD file, 2026-10-29]
generative/out/turret.stl
119.0 x 36.5 x 136.3
