connorwhite-online/grip/generative/v3/out/wrist_yoke.stl

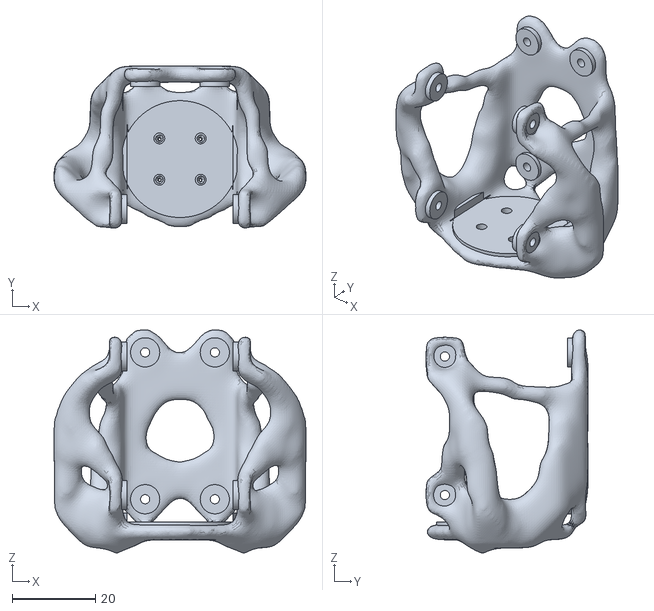
[picture p37: CAD file, 2026-10-29]
generative/v3/out/wrist_yoke.stl
60.4 x 38.8 x 53.4
