connorwhite-online/grip/urdf/meshes/jaw_a.stl

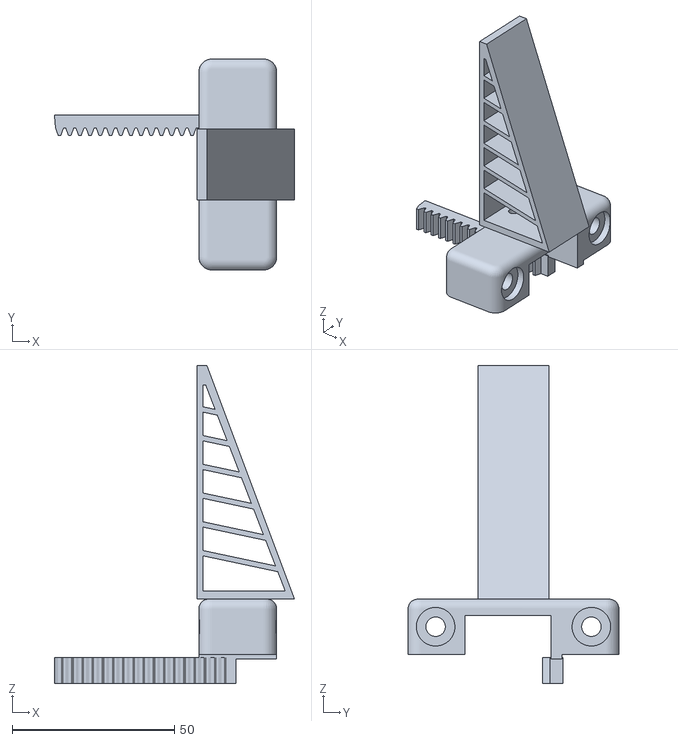
[picture p38: CAD file, 2026-10-27]
urdf/meshes/jaw_a.stl
74.0 x 65.0 x 98.0
