connorwhite-online/grip/exports/fdm/step/j1_j3_drive_eccentric.step

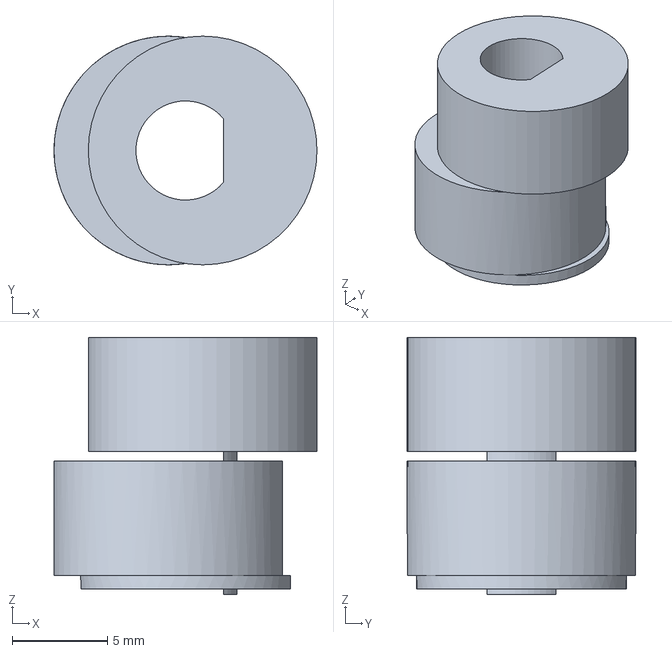
[picture p39: CAD file, 2026-10-28]
exports/fdm/step/j1_j3_drive_eccentric.step
13.8 x 12.0 x 13.5 mm
