connorwhite-online/grip/exports/stl/kits/kit_wrist_drive.stl

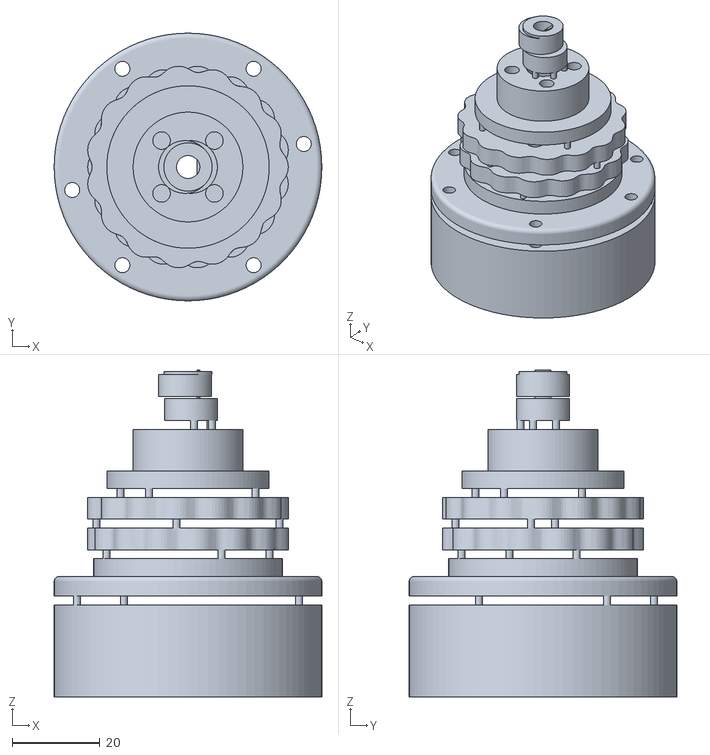
[picture p40: CAD file, 2026-10-27]
exports/stl/kits/kit_wrist_drive.stl
61.0 x 61.0 x 74.5
