connorwhite-online/grip/generative/hand/finger-wrap.stl

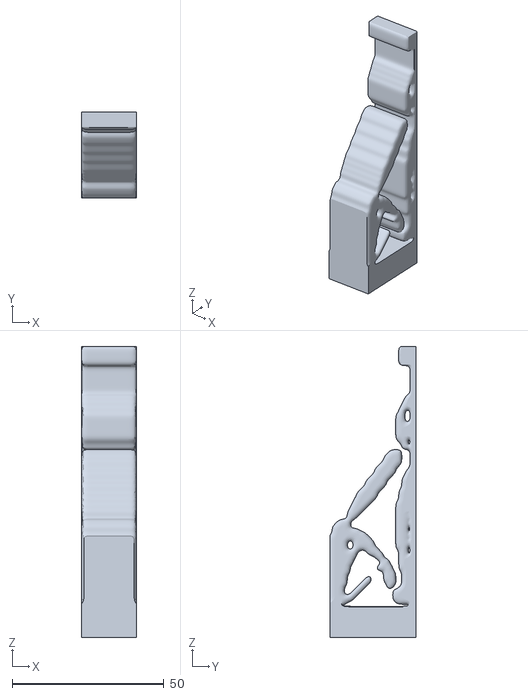
[picture p41: CAD file, 2026-10-29]
generative/hand/finger-wrap.stl
18.0 x 28.5 x 96.0
