connorwhite-online/grip/generative/out/forearm.stl

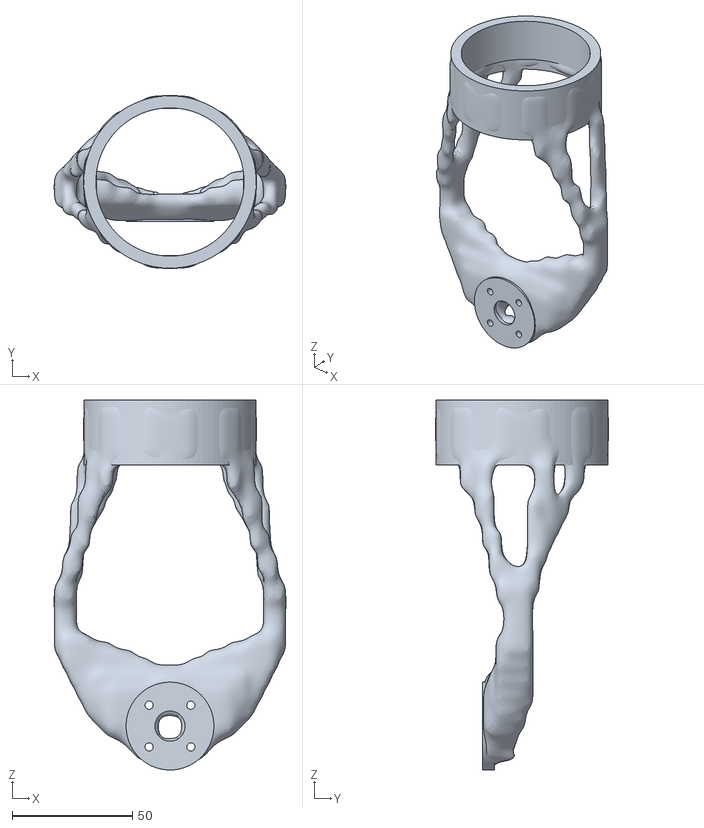
[picture p42: CAD file, 2026-10-29]
generative/out/forearm.stl
96.2 x 71.8 x 153.8
