connorwhite-online/grip/generative/v3/out/wrist_link.stl

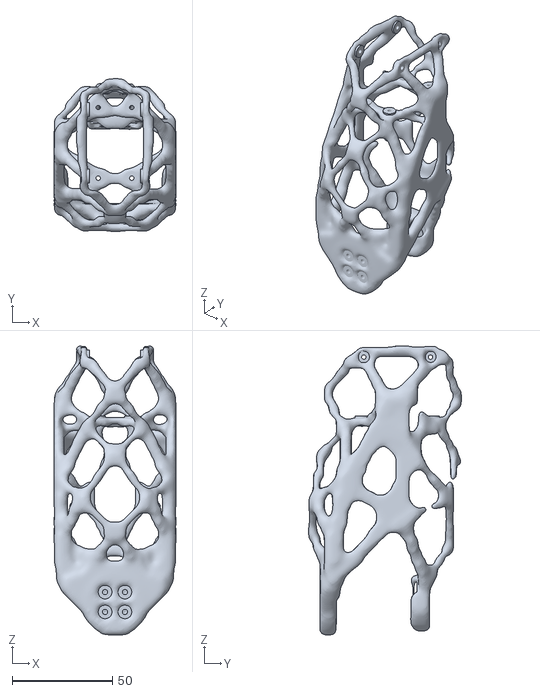
[picture p43: CAD file, 2026-10-29]
generative/v3/out/wrist_link.stl
60.6 x 76.1 x 144.0
