connorwhite-online/grip/urdf/meshes/upper_arm.stl

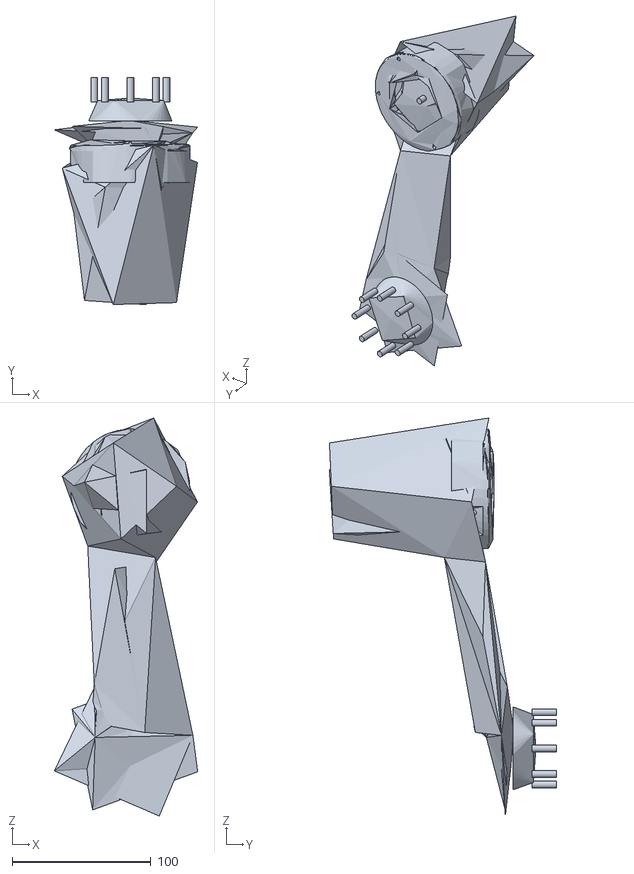
[picture p44: CAD file, 2026-10-27]
urdf/meshes/upper_arm.stl
103.3 x 164.0 x 286.9
