connorwhite-online/grip/exports/fdm/step/j1_j3_drive_housing.step

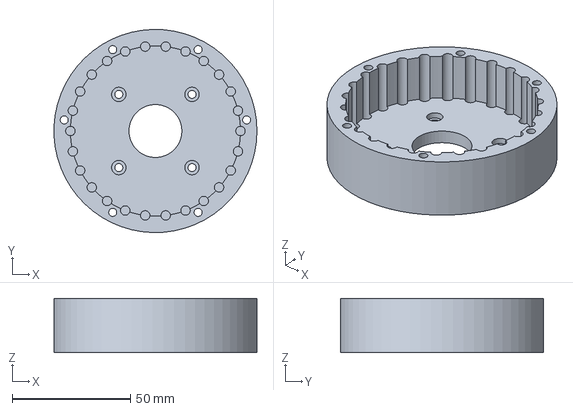
[picture p45: CAD file, 2026-10-28]
exports/fdm/step/j1_j3_drive_housing.step
85.9 x 86.0 x 23.0 mm
