connorwhite-online/grip/exports/stl/kits/kit_fingers.stl

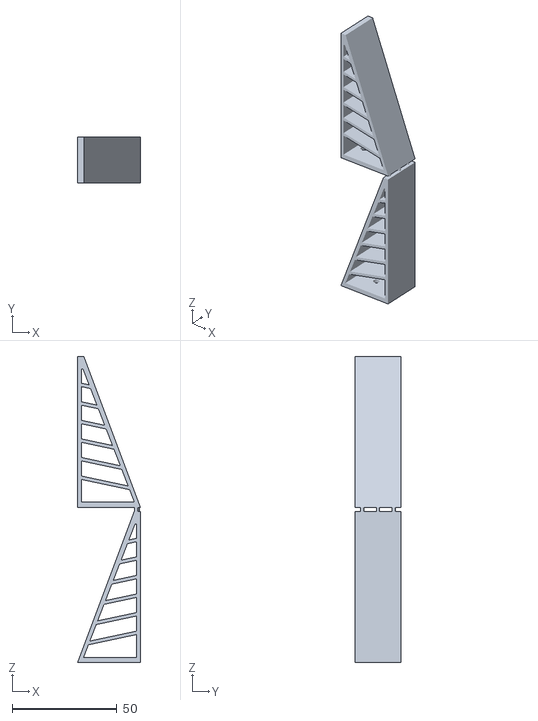
[picture p46: CAD file, 2026-10-27]
exports/stl/kits/kit_fingers.stl
30.0 x 22.0 x 146.0
