connorwhite-online/grip/generative/hand/palm.stl

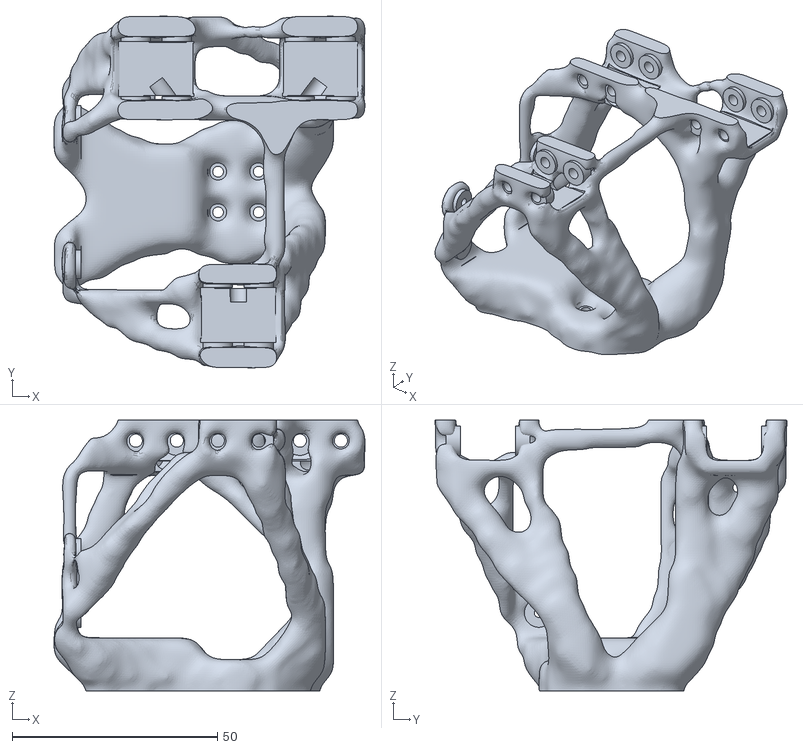
[picture p47: CAD file, 2026-10-29]
generative/hand/palm.stl
75.8 x 85.7 x 66.0
