connorwhite-online/grip/generative/out/wrist_yoke.stl

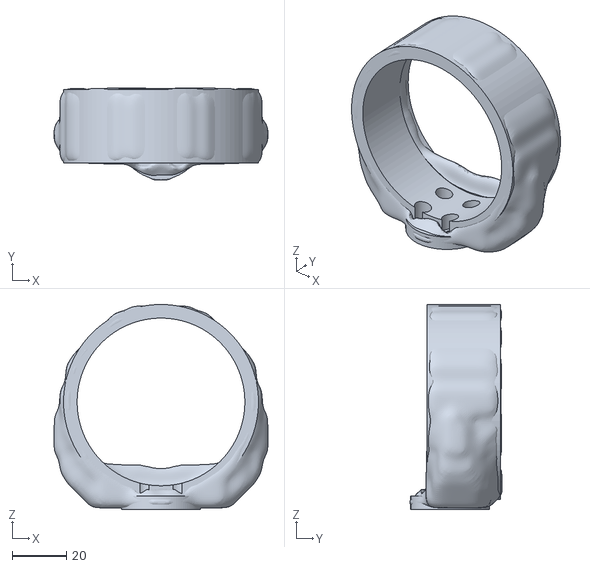
[picture p48: CAD file, 2026-10-29]
generative/out/wrist_yoke.stl
78.6 x 33.9 x 75.3
