connorwhite-online/grip/generative/v3/out/upper_arm.stl

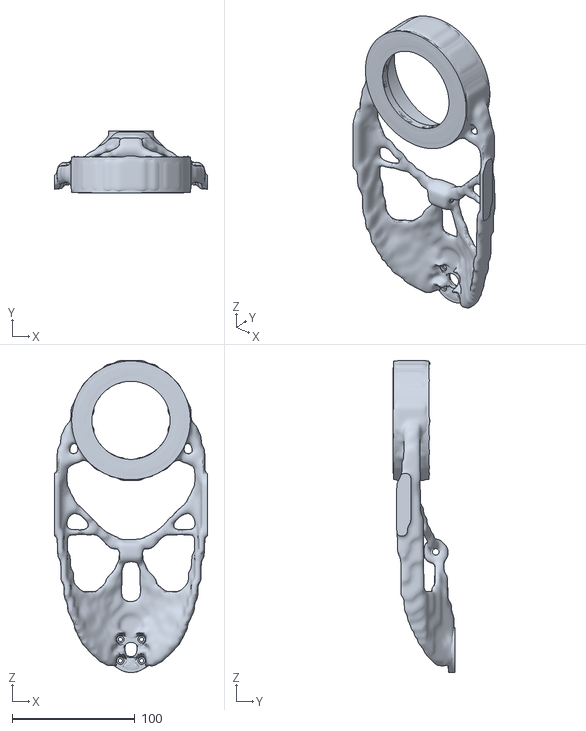
[picture p49: CAD file, 2026-10-29]
generative/v3/out/upper_arm.stl
124.6 x 50.1 x 253.9
