connorwhite-online/grip/urdf/meshes/wrist_link.stl

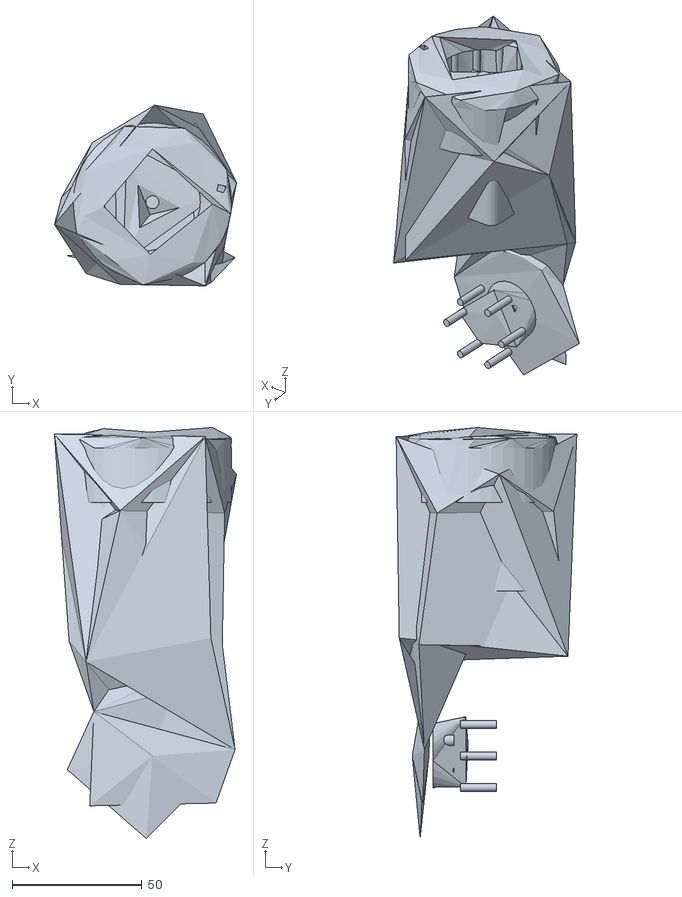
[picture p50: CAD file, 2026-10-27]
urdf/meshes/wrist_link.stl
70.1 x 69.6 x 158.2
