connorwhite-online/grip/exports/fdm/step/wrist_drive_disc_a.step

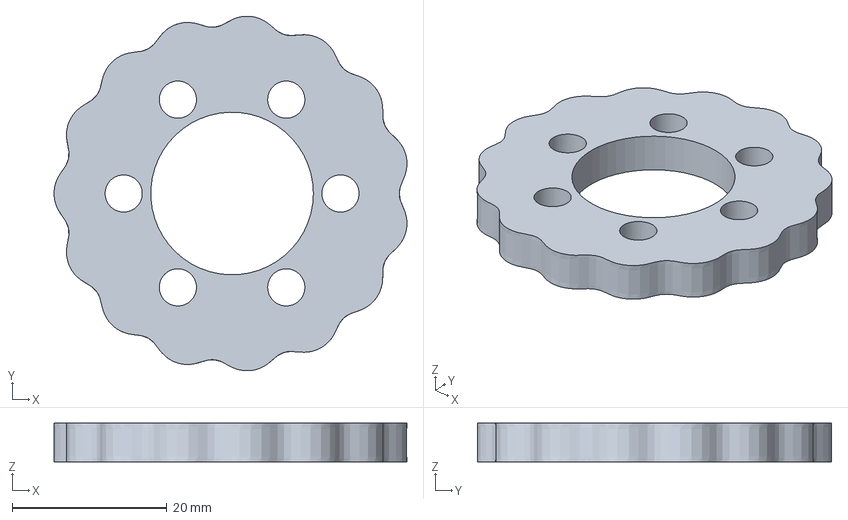
[picture p51: CAD file, 2026-10-28]
exports/fdm/step/wrist_drive_disc_a.step
45.6 x 45.8 x 5.00 mm
