connorwhite-online/grip/exports/step/j2_drive_eccentric.step

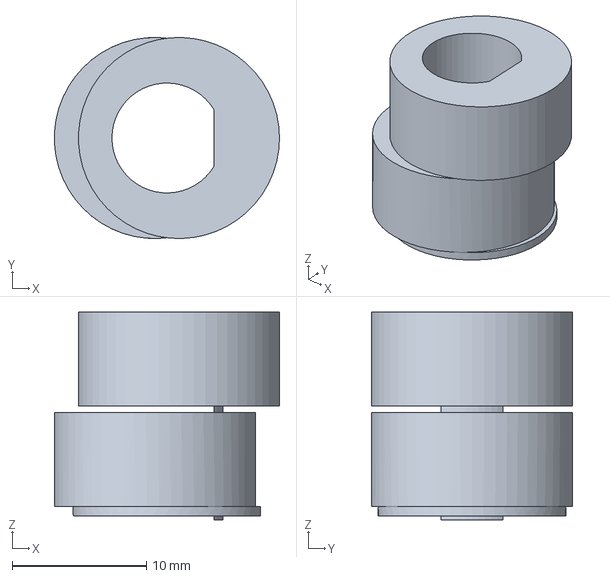
[picture p52: CAD file, 2026-10-28]
exports/step/j2_drive_eccentric.step
16.8 x 15.0 x 15.5 mm
