connorwhite-online/grip/urdf/meshes/base_link.stl

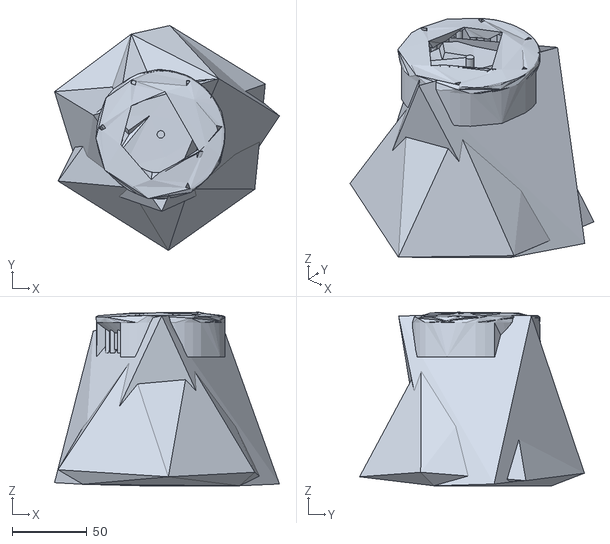
[picture p53: CAD file, 2026-10-27]
urdf/meshes/base_link.stl
150.5 x 150.4 x 116.1
