connorwhite-online/grip/exports/fdm/step/base.step

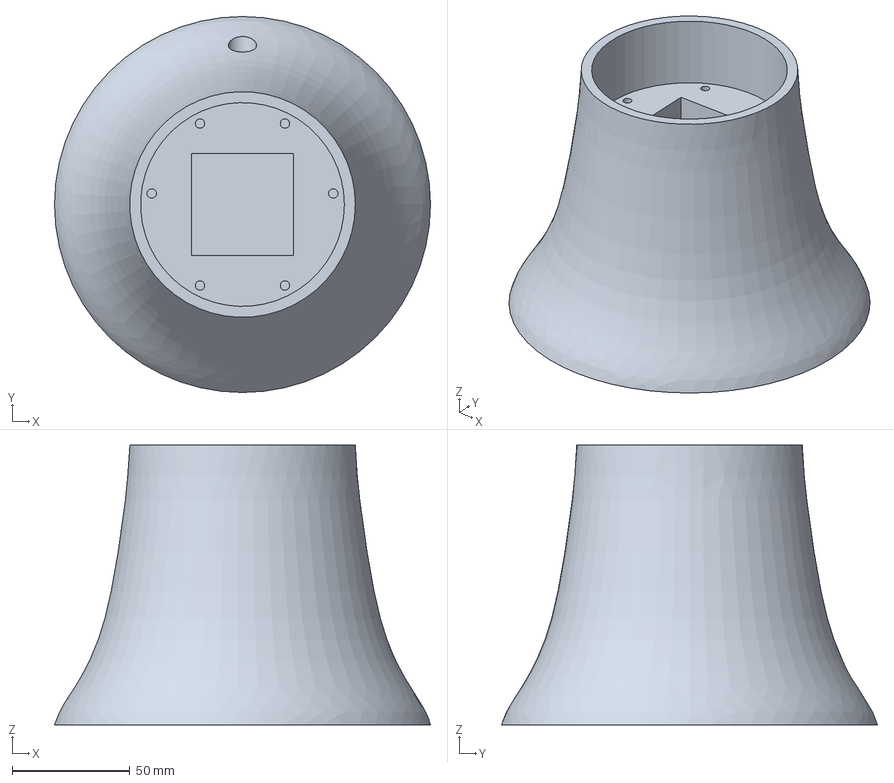
[picture p54: CAD file, 2026-10-28]
exports/fdm/step/base.step
160.0 x 160.0 x 119.0 mm
