connorwhite-online/grip/exports/step/gripper_finger.step

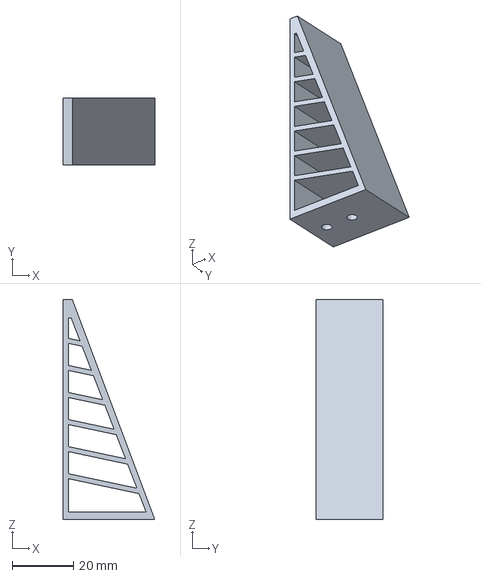
[picture p55: CAD file, 2026-10-28]
exports/step/gripper_finger.step
30.0 x 22.0 x 72.0 mm
