connorwhite-online/grip/urdf/meshes/wrist_yoke.stl

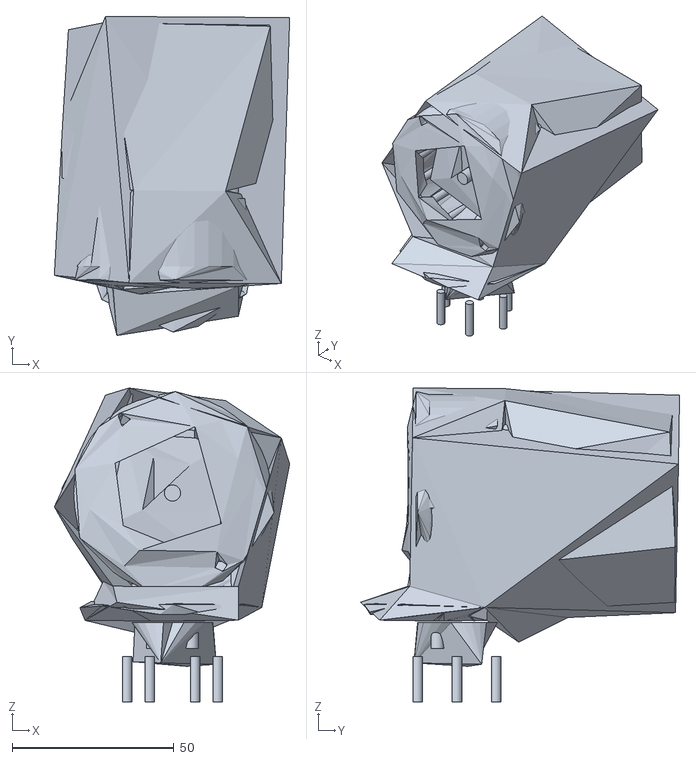
[picture p56: CAD file, 2026-10-27]
urdf/meshes/wrist_yoke.stl
72.7 x 98.5 x 96.9
