connorwhite-online/grip/exports/fdm/step/j2_drive_housing.step

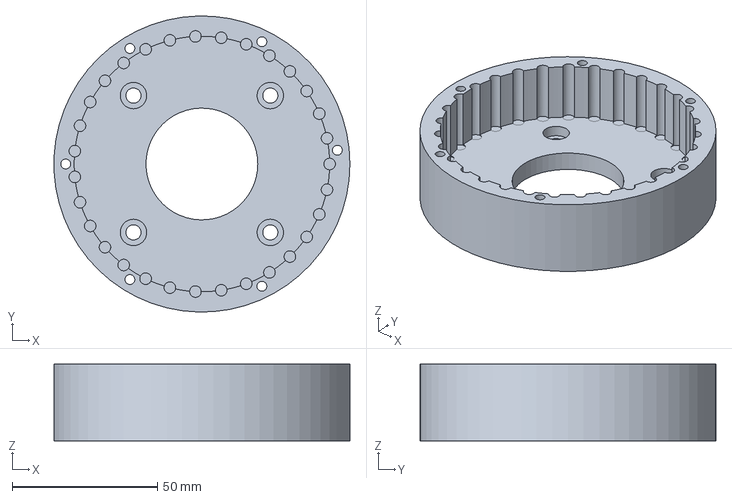
[picture p57: CAD file, 2026-10-28]
exports/fdm/step/j2_drive_housing.step
101.9 x 102.0 x 26.5 mm
