connorwhite-online/grip/urdf/meshes/turret.stl

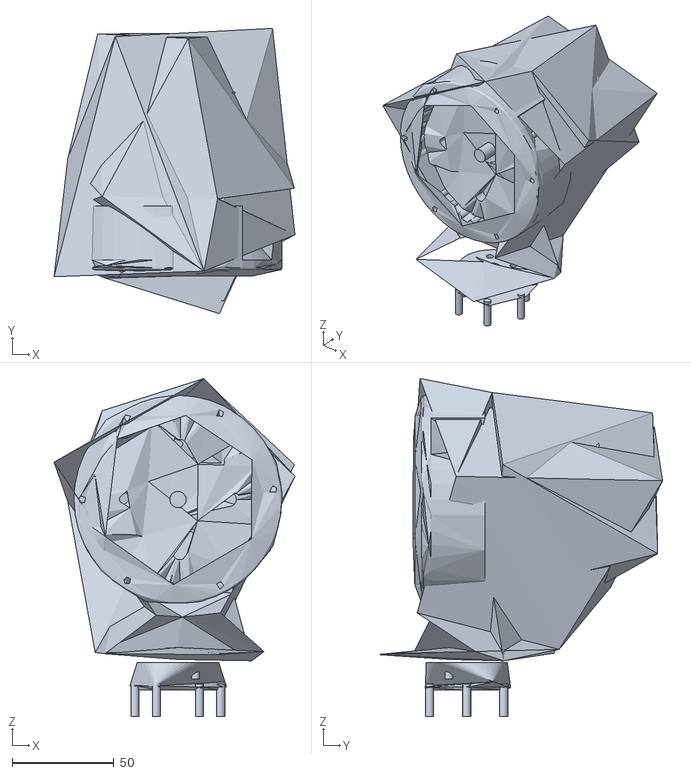
[picture p58: CAD file, 2026-10-27]
urdf/meshes/turret.stl
118.2 x 140.0 x 165.9
