connorwhite-online/grip/exports/fdm/step/forearm.step

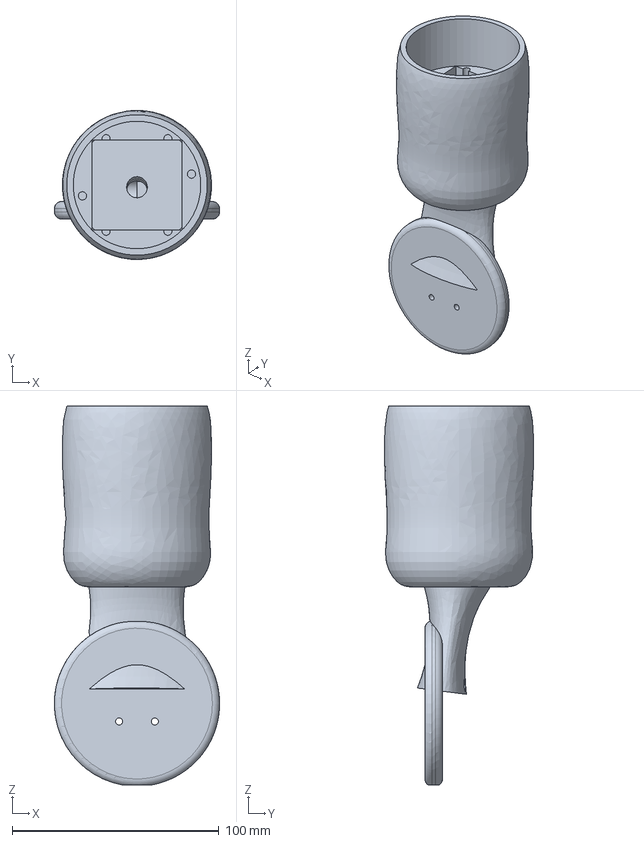
[picture p59: CAD file, 2026-10-28]
exports/fdm/step/forearm.step
80.0 x 72.2 x 183.4 mm
