connorwhite-online/grip/exports/step/wrist_link.step

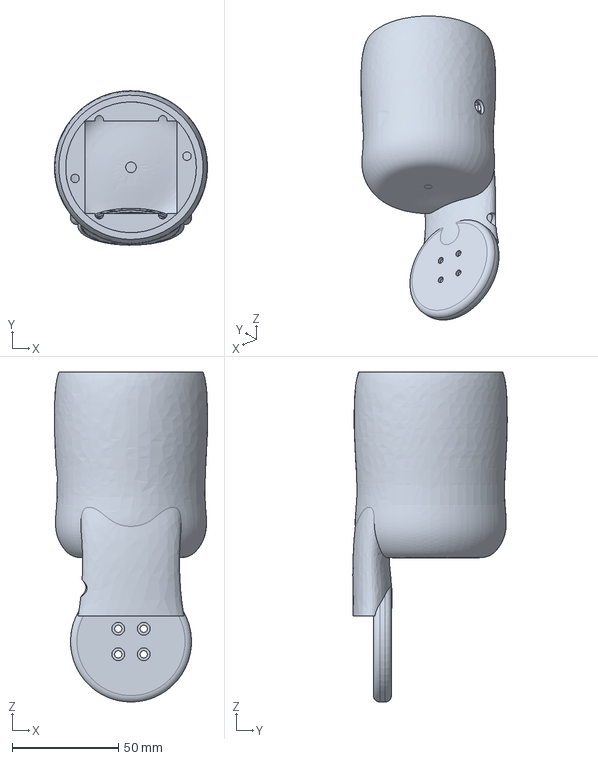
[picture p60: CAD file, 2026-10-28]
exports/step/wrist_link.step
72.2 x 72.8 x 155.5 mm
