connorwhite-online/grip/exports/step/wrist_drive_output_flange.step

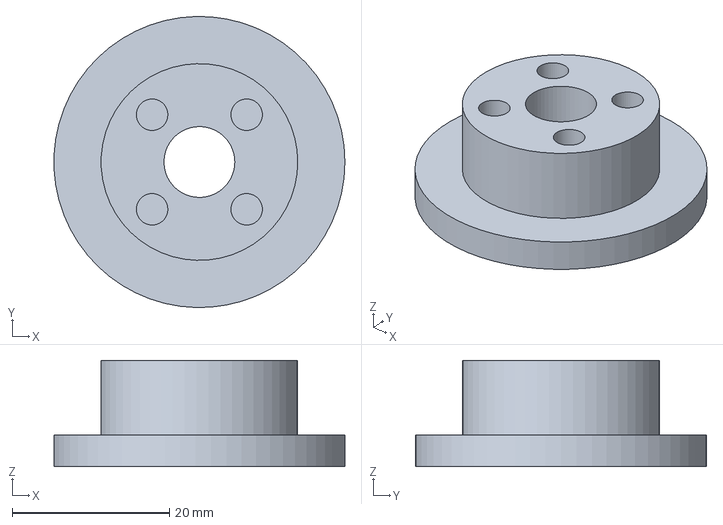
[picture p61: CAD file, 2026-10-28]
exports/step/wrist_drive_output_flange.step
37.0 x 37.0 x 13.5 mm
