connorwhite-online/grip/exports/step/j1_j3_drive_cap.step

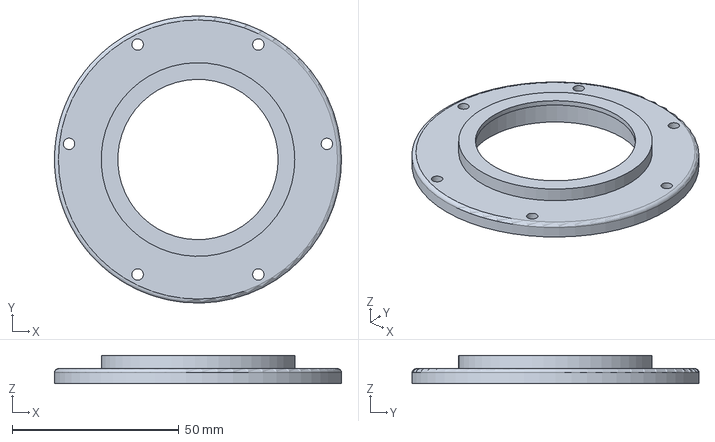
[picture p62: CAD file, 2026-10-28]
exports/step/j1_j3_drive_cap.step
86.0 x 86.0 x 8.50 mm
