connorwhite-online/grip/exports/fdm/step/gripper_camera_mount.step

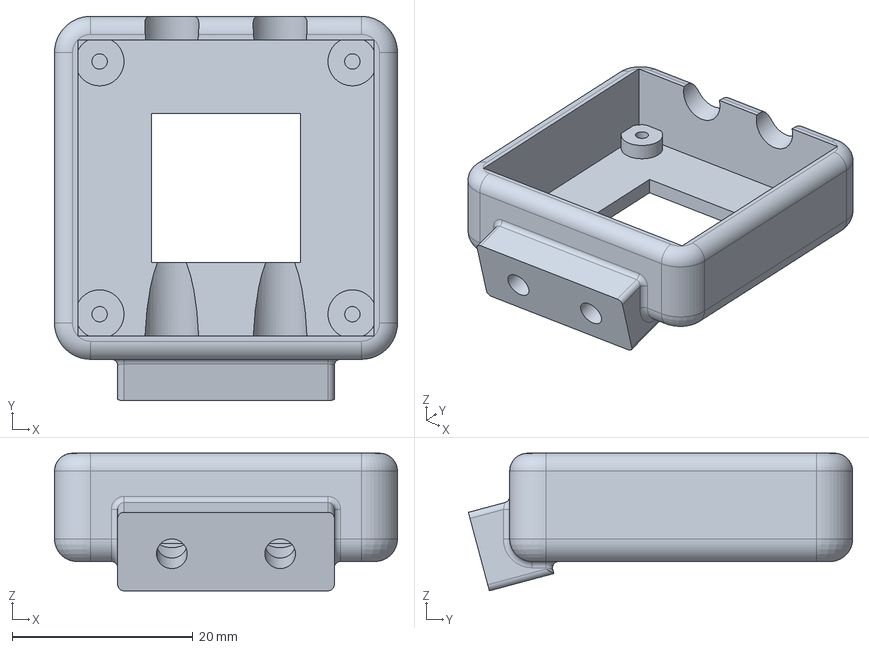
[picture p63: CAD file, 2026-10-28]
exports/fdm/step/gripper_camera_mount.step
38.0 x 42.6 x 15.2 mm
