connorwhite-online/grip/exports/step/j1_j3_drive_disc_b.step

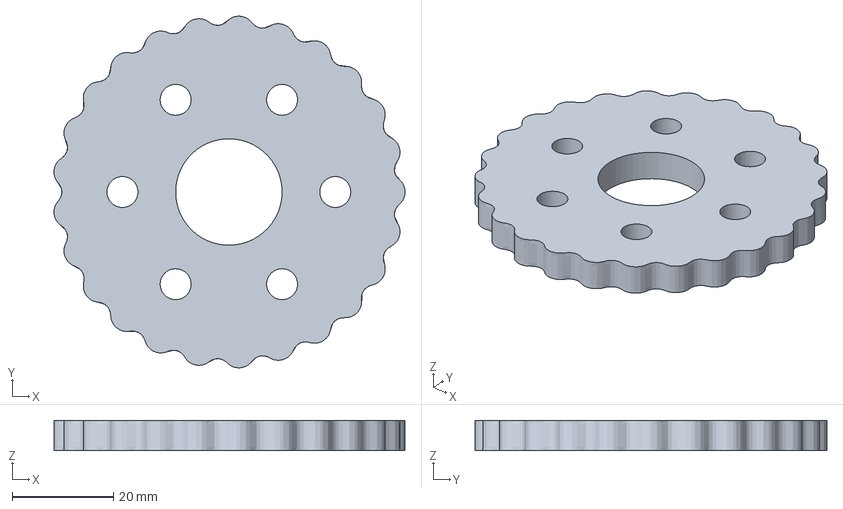
[picture p64: CAD file, 2026-10-28]
exports/step/j1_j3_drive_disc_b.step
69.3 x 69.4 x 6.00 mm
