connorwhite-online/grip/exports/fdm/step/gripper_frame.step

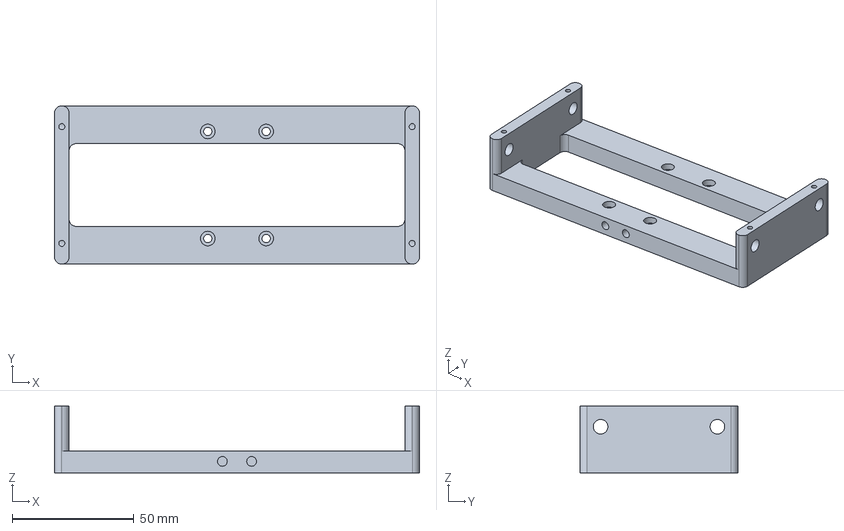
[picture p65: CAD file, 2026-10-28]
exports/fdm/step/gripper_frame.step
150.0 x 65.0 x 27.5 mm
