connorwhite-online/grip/exports/step/wrist_drive_cap.step

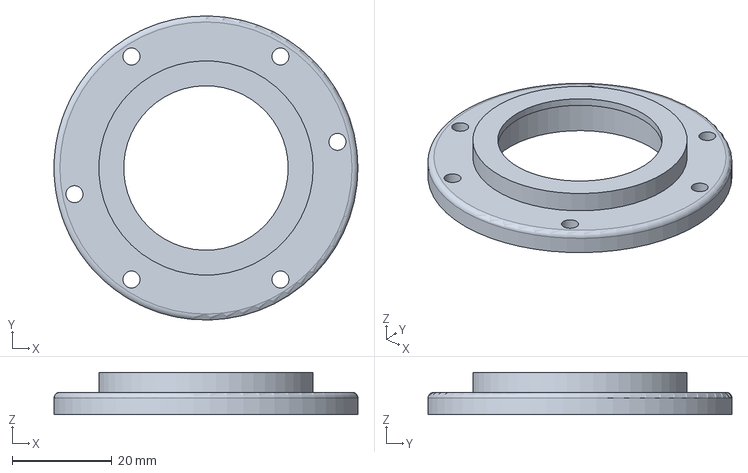
[picture p66: CAD file, 2026-10-28]
exports/step/wrist_drive_cap.step
61.0 x 61.0 x 8.50 mm
