connorwhite-online/grip/exports/fdm/step/upper_arm.step

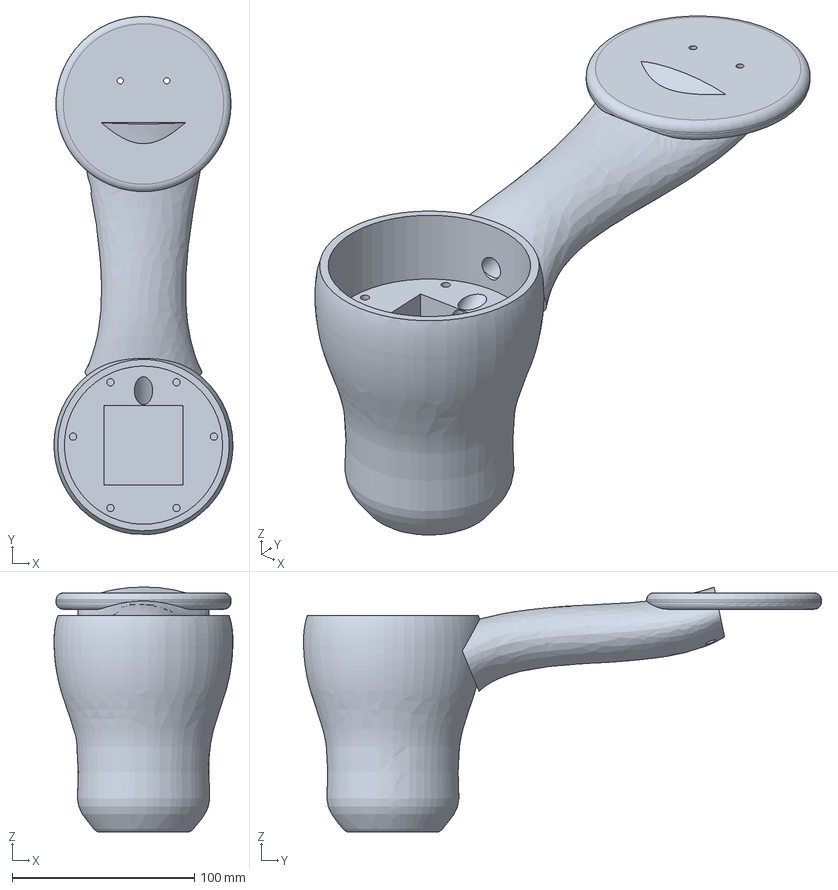
[picture p67: CAD file, 2026-10-28]
exports/fdm/step/upper_arm.step
98.1 x 284.0 x 134.3 mm
