connorwhite-online/grip/exports/step/upper_arm.step

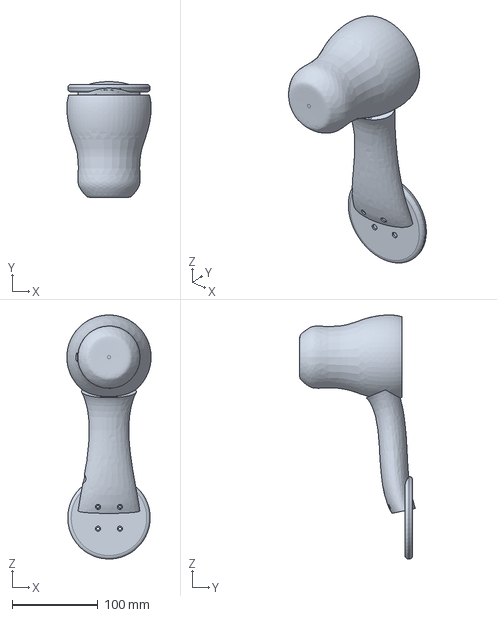
[picture p68: CAD file, 2026-10-28]
exports/step/upper_arm.step
98.0 x 134.9 x 284.1 mm
