connorwhite-online/grip/exports/fdm/step/wrist_link.step

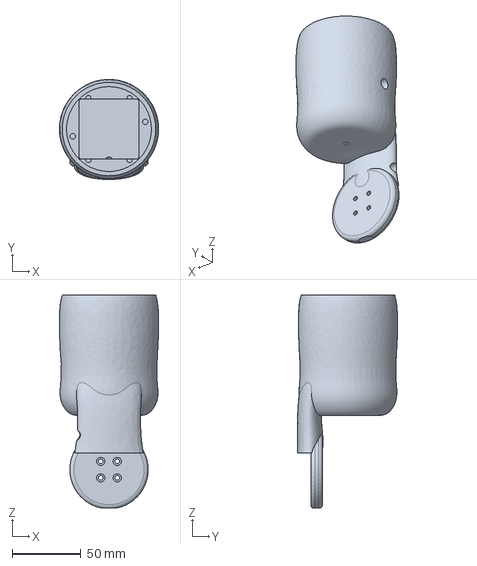
[picture p69: CAD file, 2026-10-28]
exports/fdm/step/wrist_link.step
72.2 x 72.8 x 154.9 mm
