connorwhite-online/grip/exports/step/forearm.step

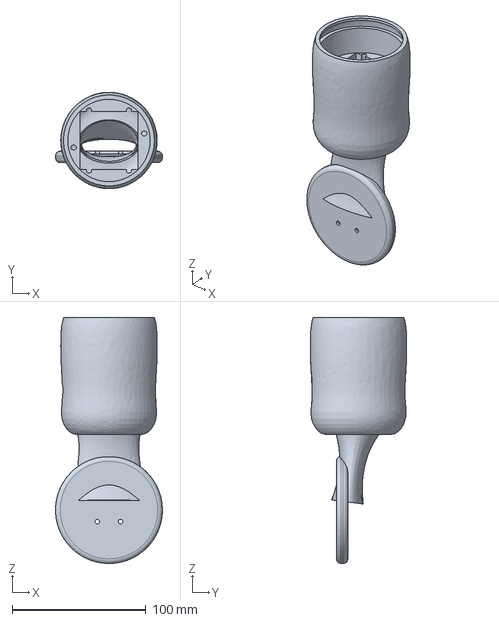
[picture p70: CAD file, 2026-10-28]
exports/step/forearm.step
80.0 x 72.2 x 184.0 mm
