connorwhite-online/grip/exports/step/gripper_pinion.step

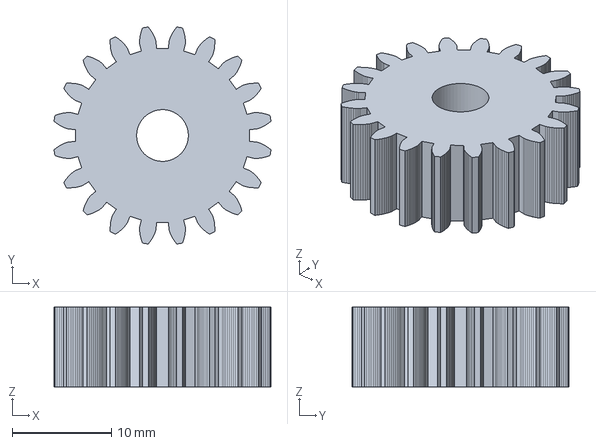
[picture p71: CAD file, 2026-10-28]
exports/step/gripper_pinion.step
21.8 x 21.8 x 8.00 mm
