connorwhite-online/grip/exports/fdm/step/gripper_jaw.step

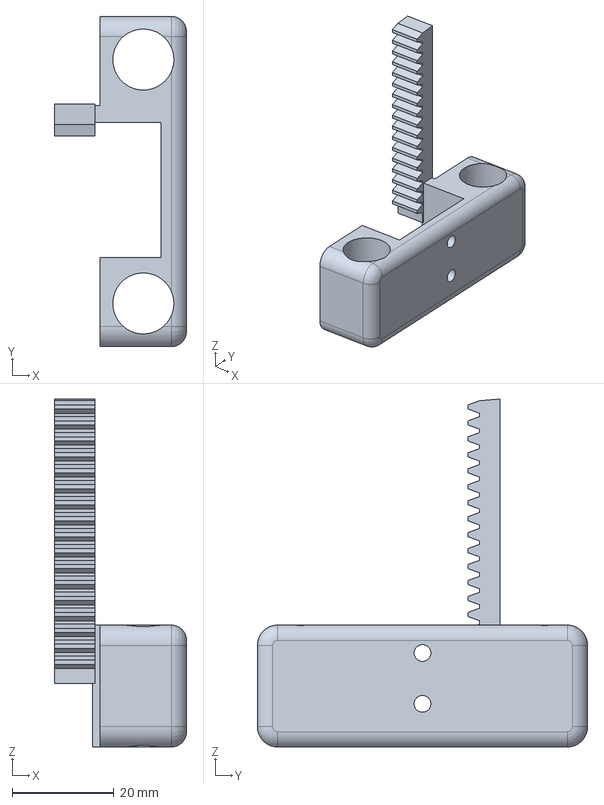
[picture p72: CAD file, 2026-10-28]
exports/fdm/step/gripper_jaw.step
26.0 x 65.0 x 68.5 mm
