connorwhite-online/grip/exports/step/gripper_palm.step

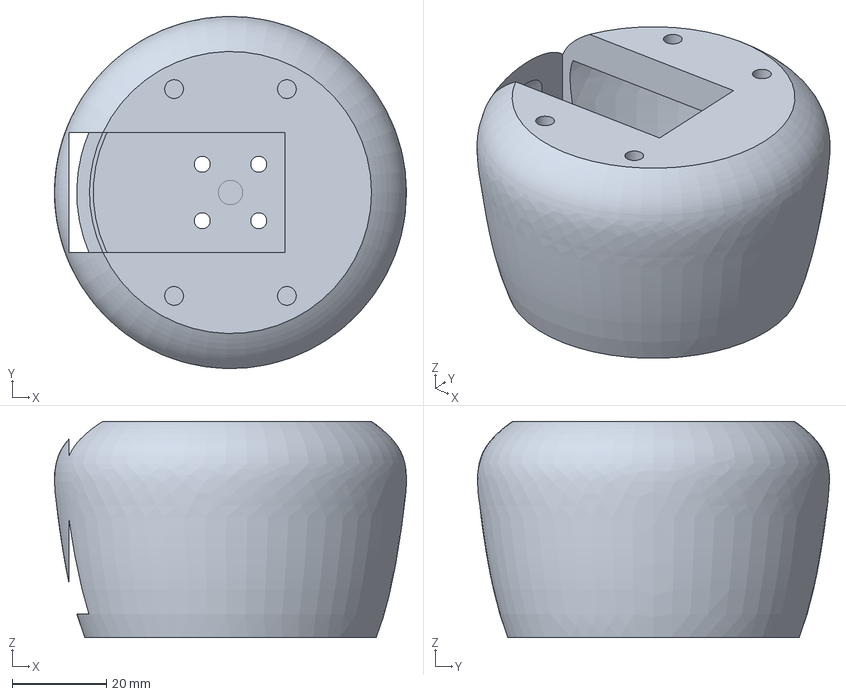
[picture p73: CAD file, 2026-10-28]
exports/step/gripper_palm.step
74.9 x 74.9 x 46.0 mm
