connorwhite-online/grip/exports/step/j2_drive_cap.step

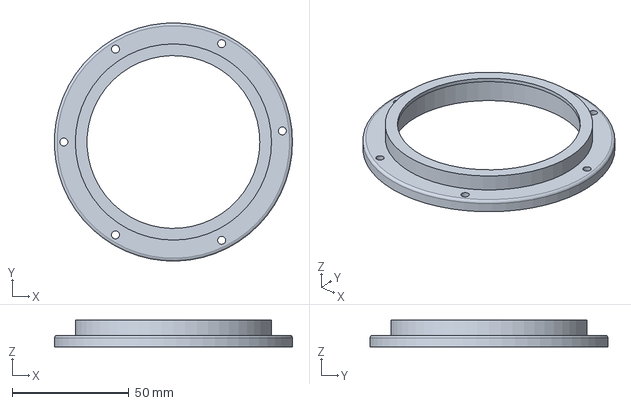
[picture p74: CAD file, 2026-10-28]
exports/step/j2_drive_cap.step
101.9 x 102.0 x 11.5 mm
