connorwhite-online/grip/exports/step/gripper_camera_mount.step

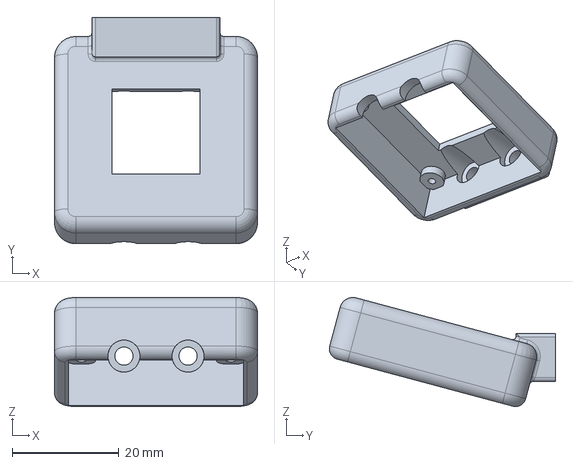
[picture p75: CAD file, 2026-10-28]
exports/step/gripper_camera_mount.step
38.0 x 42.4 x 20.4 mm
