connorwhite-online/grip/exports/fdm/step/wrist_yoke.step

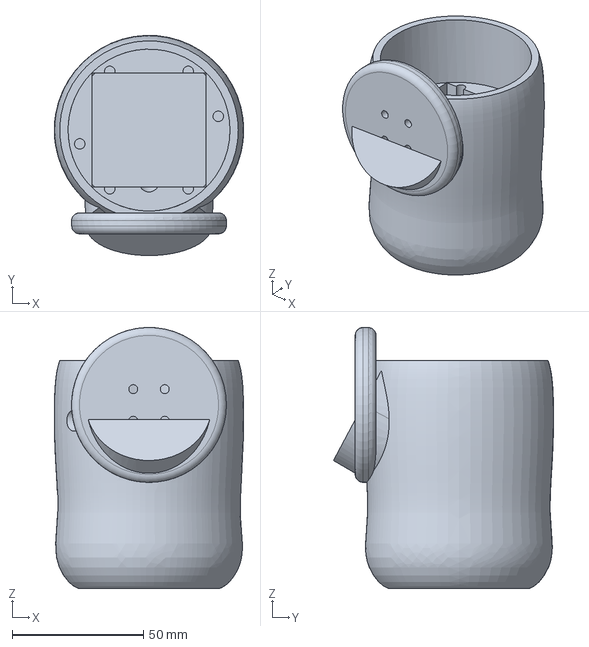
[picture p76: CAD file, 2026-10-28]
exports/fdm/step/wrist_yoke.step
72.2 x 83.9 x 99.4 mm
