connorwhite-online/grip/exports/step/wrist_yoke.step

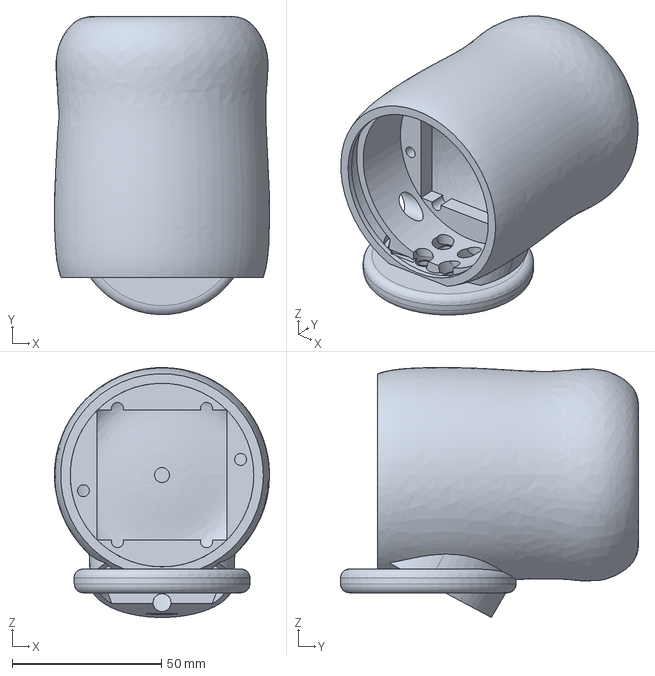
[picture p77: CAD file, 2026-10-28]
exports/step/wrist_yoke.step
72.2 x 100.0 x 83.9 mm
