connorwhite-online/grip/exports/fdm/step/fit_coupon.step

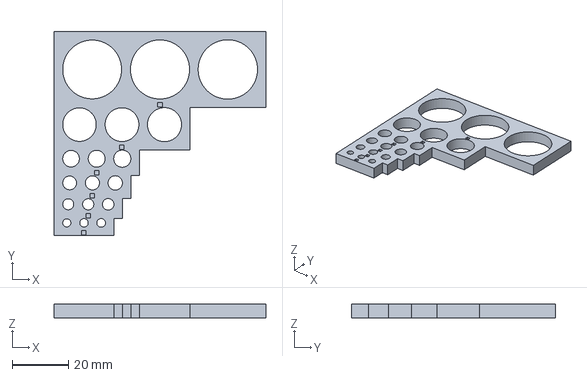
[picture p78: CAD file, 2026-10-28]
exports/fdm/step/fit_coupon.step
75.3 x 72.6 x 5.00 mm
