connorwhite-online/grip/(list of files, cad)

Other CAD files:
exports/step/wrist_drive_housing.step
exports/step/turret.step
urdf/meshes/jaw_b.stl
exports/fdm/step/j2_drive_eccentric.step
exports/step/wrist_drive_disc_a.step
exports/fdm/step/wrist_drive_disc_b.step
exports/fdm/step/wrist_drive_eccentric.step
exports/fdm/step/j2_drive_disc_a.step
exports/step/j2_drive_housing.step
exports/fdm/step/gripper_finger.step
exports/step/j1_j3_drive_housing.step
exports/fdm/step/wrist_drive_cap.step
exports/fdm/step/j1_j3_drive_disc_b.step
exports/fdm/step/j2_drive_cap.step
exports/fdm/step/j1_j3_drive_cap.step
exports/step/j1_j3_drive_output_flange.step
exports/fdm/step/j1_j3_drive_disc_a.step
exports/step/gripper_jaw.step
exports/step/gripper_frame.step
exports/fdm/step/j2_drive_output_flange.step
exports/fdm/step/gripper_palm.step
exports/step/base.step
exports/fdm/step/j2_drive_disc_b.step
exports/step/j1_j3_drive_disc_a.step
exports/step/wrist_drive_disc_b.step
exports/fdm/step/gripper_pinion.step
exports/step/j2_drive_disc_b.step
exports/fdm/step/wrist_drive_output_flange.step
exports/step/j1_j3_drive_eccentric.step
exports/fdm/stl/base.stl
exports/fdm/stl/fit_coupon.stl
exports/fdm/stl/forearm.stl
exports/fdm/stl/gripper_camera_mount.stl
exports/fdm/stl/gripper_finger.stl
exports/fdm/stl/gripper_frame.stl
exports/fdm/stl/gripper_jaw.stl
exports/fdm/stl/gripper_palm.stl
exports/fdm/stl/gripper_pinion.stl
exports/fdm/stl/j1_j3_drive_cap.stl
exports/fdm/stl/j1_j3_drive_disc_a.stl
exports/fdm/stl/j1_j3_drive_disc_b.stl
exports/fdm/stl/j1_j3_drive_eccentric.stl
exports/fdm/stl/j1_j3_drive_housing.stl
exports/fdm/stl/j1_j3_drive_output_flange.stl
exports/fdm/stl/j2_drive_cap.stl
exports/fdm/stl/j2_drive_disc_a.stl
exports/fdm/stl/j2_drive_disc_b.stl
exports/fdm/stl/j2_drive_eccentric.stl
exports/fdm/stl/j2_drive_housing.stl
exports/fdm/stl/j2_drive_output_flange.stl
exports/fdm/stl/turret.stl
exports/fdm/stl/upper_arm.stl
exports/fdm/stl/wrist_drive_cap.stl
exports/fdm/stl/wrist_drive_disc_a.stl
exports/fdm/stl/wrist_drive_disc_b.stl
exports/fdm/stl/wrist_drive_eccentric.stl
exports/fdm/stl/wrist_drive_housing.stl
exports/fdm/stl/wrist_drive_output_flange.stl
exports/fdm/stl/wrist_link.stl
exports/fdm/stl/wrist_yoke.stl
exports/stl/base.stl
exports/stl/forearm.stl
exports/stl/gripper_camera_mount.stl
exports/stl/gripper_finger.stl
exports/stl/gripper_frame.stl
exports/stl/gripper_jaw.stl
exports/stl/gripper_palm.stl
exports/stl/gripper_pinion.stl
exports/stl/j1_j3_drive_cap.stl
exports/stl/j1_j3_drive_disc_a.stl
exports/stl/j1_j3_drive_disc_b.stl
exports/stl/j1_j3_drive_eccentric.stl
exports/stl/j1_j3_drive_housing.stl
exports/stl/j1_j3_drive_output_flange.stl
exports/stl/j2_drive_cap.stl
exports/stl/j2_drive_disc_a.stl
exports/stl/j2_drive_disc_b.stl
exports/stl/j2_drive_eccentric.stl
exports/stl/j2_drive_housing.stl
exports/stl/j2_drive_output_flange.stl
exports/stl/turret.stl
exports/stl/upper_arm.stl
exports/stl/wrist_drive_cap.stl
exports/stl/wrist_drive_disc_a.stl
exports/stl/wrist_drive_disc_b.stl
exports/stl/wrist_drive_eccentric.stl
exports/stl/wrist_drive_housing.stl
exports/stl/wrist_drive_output_flange.stl
exports/stl/wrist_link.stl
exports/stl/wrist_yoke.stl
