connorwhite-online/grip/generative/print/grip-wrist-yoke-PETG-FDM-v3.png

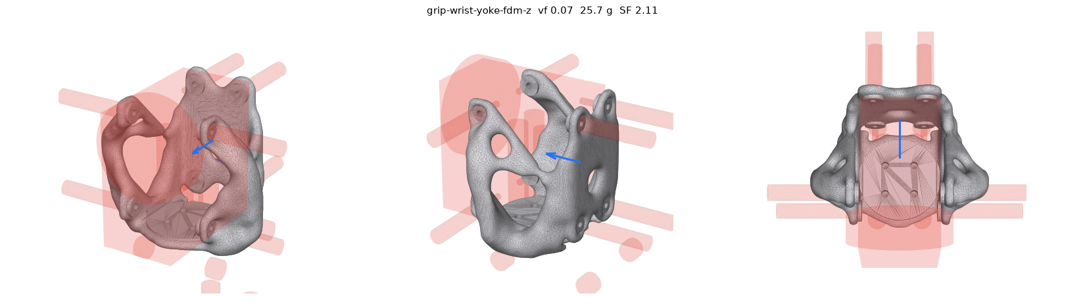
generative/print/grip-wrist-yoke-PETG-FDM-v3.png
