connorwhite-online/grip/urdf/grip.urdf

<?xml version="1.0"?>
<!-- Generated by cad/urdf.py from the GRIP CAD. Do not edit by hand. -->
<robot name="grip">
  <link name="base_link">
    <inertial><origin xyz="1.29996e-05 -2.06403e-05 0.0679574"/><mass value="0.9536"/>
      <inertia ixx="0.00129185" ixy="-1.858e-07" ixz="2.82899e-06" iyy="0.00129247" iyz="3.15067e-06" izz="0.000925925"/></inertial>
    <visual><origin xyz="-0 -0 -0"/><geometry><mesh filename="meshes/base_link.stl" scale="0.001 0.001 0.001"/></geometry></visual>
    <collision><origin xyz="-0 -0 -0"/><geometry><mesh filename="meshes/base_link.stl" scale="0.001 0.001 0.001"/></geometry></collision>
  </link>
  <link name="turret">
    <inertial><origin xyz="0.00010235 0.0197137 0.195869"/><mass value="1.4109"/>
      <inertia ixx="0.00223301" ixy="4.1106e-06" ixz="-6.31158e-07" iyy="0.00195646" iyz="-0.00010455" izz="0.0017922"/></inertial>
    <visual><origin xyz="-0 -0 -0"/><geometry><mesh filename="meshes/turret.stl" scale="0.001 0.001 0.001"/></geometry></visual>
    <collision><origin xyz="-0 -0 -0"/><geometry><mesh filename="meshes/turret.stl" scale="0.001 0.001 0.001"/></geometry></collision>
  </link>
  <link name="upper_arm">
    <inertial><origin xyz="2.40801e-05 -0.0522133 0.163299"/><mass value="1.0554"/>
      <inertia ixx="0.00527616" ixy="-1.75393e-08" ixz="-5.92128e-07" iyy="0.00450346" iyz="0.0013512" izz="0.00147447"/></inertial>
    <visual><origin xyz="-0 0.03 -0.2"/><geometry><mesh filename="meshes/upper_arm.stl" scale="0.001 0.001 0.001"/></geometry></visual>
    <collision><origin xyz="-0 0.03 -0.2"/><geometry><mesh filename="meshes/upper_arm.stl" scale="0.001 0.001 0.001"/></geometry></collision>
  </link>
  <link name="forearm">
    <inertial><origin xyz="1.9918e-05 0.0146561 0.0944387"/><mass value="0.4897"/>
      <inertia ixx="0.000839341" ixy="1.38187e-07" ixz="8.10155e-08" iyy="0.000826591" iyz="-0.000108881" izz="0.000233217"/></inertial>
    <visual><origin xyz="-0 0.042 -0.387"/><geometry><mesh filename="meshes/forearm.stl" scale="0.001 0.001 0.001"/></geometry></visual>
    <collision><origin xyz="-0 0.042 -0.387"/><geometry><mesh filename="meshes/forearm.stl" scale="0.001 0.001 0.001"/></geometry></collision>
  </link>
  <link name="wrist_yoke">
    <inertial><origin xyz="2.5881e-05 0.0194151 0.0375499"/><mass value="0.4586"/>
      <inertia ixx="0.000306849" ixy="-5.22134e-08" ixz="2.92491e-07" iyy="0.000245727" iyz="-2.19731e-05" izz="0.000259257"/></inertial>
    <visual><origin xyz="-0 0.025 -0.532"/><geometry><mesh filename="meshes/wrist_yoke.stl" scale="0.001 0.001 0.001"/></geometry></visual>
    <collision><origin xyz="-0 0.025 -0.532"/><geometry><mesh filename="meshes/wrist_yoke.stl" scale="0.001 0.001 0.001"/></geometry></collision>
  </link>
  <link name="wrist_link">
    <inertial><origin xyz="1.02851e-05 0.0170718 0.084359"/><mass value="0.4609"/>
      <inertia ixx="0.00045475" ixy="1.33768e-07" ixz="-8.43876e-08" iyy="0.000448344" iyz="-3.44325e-05" izz="0.000205217"/></inertial>
    <visual><origin xyz="-0 0.043 -0.572"/><geometry><mesh filename="meshes/wrist_link.stl" scale="0.001 0.001 0.001"/></geometry></visual>
    <collision><origin xyz="-0 0.043 -0.572"/><geometry><mesh filename="meshes/wrist_link.stl" scale="0.001 0.001 0.001"/></geometry></collision>
  </link>
  <link name="tool">
    <inertial><origin xyz="-0.00209797 -0.00440401 0.0427588"/><mass value="0.2572"/>
      <inertia ixx="0.000291774" ixy="2.36799e-06" ixz="-1.09405e-05" iyy="0.000469669" iyz="1.76822e-05" izz="0.000476755"/></inertial>
    <visual><origin xyz="-0 0.025 -0.7"/><geometry><mesh filename="meshes/tool.stl" scale="0.001 0.001 0.001"/></geometry></visual>
    <collision><origin xyz="-0 0.025 -0.7"/><geometry><mesh filename="meshes/tool.stl" scale="0.001 0.001 0.001"/></geometry></collision>
  </link>
  <link name="jaw_a">
    <inertial><origin xyz="0.0101033 0.00110157 0.0753741"/><mass value="0.0480"/>
      <inertia ixx="3.8278e-05" ixy="8.82633e-07" ixz="2.16238e-07" iyy="2.61007e-05" iyz="1.05274e-06" izz="2.20661e-05"/></inertial>
    <visual><origin xyz="-0 0.025 -0.7"/><geometry><mesh filename="meshes/jaw_a.stl" scale="0.001 0.001 0.001"/></geometry></visual>
    <collision><origin xyz="-0 0.025 -0.7"/><geometry><mesh filename="meshes/jaw_a.stl" scale="0.001 0.001 0.001"/></geometry></collision>
  </link>
  <link name="jaw_b">
    <inertial><origin xyz="-0.0101033 -0.00110157 0.0753741"/><mass value="0.0480"/>
      <inertia ixx="3.8278e-05" ixy="8.82638e-07" ixz="-2.16238e-07" iyy="2.61007e-05" iyz="-1.05265e-06" izz="2.20661e-05"/></inertial>
    <visual><origin xyz="-0 0.025 -0.7"/><geometry><mesh filename="meshes/jaw_b.stl" scale="0.001 0.001 0.001"/></geometry></visual>
    <collision><origin xyz="-0 0.025 -0.7"/><geometry><mesh filename="meshes/jaw_b.stl" scale="0.001 0.001 0.001"/></geometry></collision>
  </link>
  <joint name="j1" type="revolute">
    <parent link="base_link"/><child link="turret"/>
    <origin xyz="0 0 0"/><axis xyz="0 0 1"/>
    <limit lower="-2.96706" upper="2.96706" effort="13.0" velocity="2.5"/>
  </joint>
  <joint name="j2" type="revolute">
    <parent link="turret"/><child link="upper_arm"/>
    <origin xyz="0 -0.03 0.2"/><axis xyz="0 1 0"/>
    <limit lower="-1.04720" upper="1.04720" effort="30.0" velocity="2.1"/>
  </joint>
  <joint name="j3" type="revolute">
    <parent link="upper_arm"/><child link="forearm"/>
    <origin xyz="0 -0.012 0.187"/><axis xyz="0 1 0"/>
    <limit lower="-2.09440" upper="2.09440" effort="13.0" velocity="2.5"/>
  </joint>
  <joint name="j4" type="revolute">
    <parent link="forearm"/><child link="wrist_yoke"/>
    <origin xyz="0 0.017 0.145"/><axis xyz="0 0 1"/>
    <limit lower="-2.96706" upper="2.96706" effort="3.1" velocity="4.2"/>
  </joint>
  <joint name="j5" type="revolute">
    <parent link="wrist_yoke"/><child link="wrist_link"/>
    <origin xyz="0 -0.018 0.04"/><axis xyz="0 1 0"/>
    <limit lower="-1.74533" upper="1.74533" effort="3.1" velocity="4.2"/>
  </joint>
  <joint name="j6" type="revolute">
    <parent link="wrist_link"/><child link="tool"/>
    <origin xyz="0 0.018 0.128"/><axis xyz="0 0 1"/>
    <limit lower="-2.96706" upper="2.96706" effort="3.1" velocity="4.2"/>
  </joint>
  <joint name="jaw_a" type="prismatic">
    <parent link="tool"/><child link="jaw_a"/>
    <origin xyz="0 0 0"/><axis xyz="1 0 0"/>
    <limit lower="0" upper="0.04" effort="30.0" velocity="0.05"/>
  </joint>
  <joint name="jaw_b" type="prismatic">
    <parent link="tool"/><child link="jaw_b"/>
    <origin xyz="0 0 0"/><axis xyz="-1 0 0"/>
    <limit lower="0" upper="0.04" effort="30.0" velocity="0.05"/>
    <mimic joint="jaw_a" multiplier="1" offset="0"/>
  </joint>
  <link name="wrist_camera_optical"/>
  <joint name="wrist_camera" type="fixed">
    <parent link="tool"/><child link="wrist_camera_optical"/>
    <origin xyz="0 -0.055 0.054" rpy="-0.26180 0 0"/>
  </joint>
</robot>
