connorwhite-online/grip/(commit log)

2026-10-27 Concept CAD for GRIP v0.1: SLS arm with printed cycloidal joints
    Parametric build123d model of a 6-axis arm (500 mm reach, 1 kg peak payload)
    with organic hollow SLS shells, three sizes of two-disc cycloidal reducer,
    and a rack-and-pinion gripper with TPU fin-ray fingers. Exports every printed
    part as STEP and STL plus a full assembly STEP and a parts CSV.
    Claude-Session: https://claude.ai/code/session_01HFwANWvAhS26jNgU7RfycN
    [base.step, base.stl, forearm.step, forearm.stl, grip_assembly.step, gripper_finger.step, gripper_finger.stl, gripper_jaw.step]
2026-10-27 Fix printability blockers and cut print cost
    - Pods no longer close on a revolve pole; every link meshes as one closed,
    manifold body, and build.py now rejects anything that doesn't.
    - Socket sleeves fill to the skin with drained webs, so no sealed powder voids.
    - Cable ports on every link double as SLS powder escapes.
    - 2.0 mm walls, lighter sockets and a smaller base: links 1,018 -> 797 cm3.
    - Rack printed as part of each jaw.
    - Sprue kits join the 36 small parts so a bureau order is 15 pieces, not 50.
    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
    [base.step, base.stl, forearm.step, forearm.stl, grip_assembly.step, gripper_finger.step, gripper_finger.stl, gripper_jaw.step]
2026-10-27 Stack service kits into compact towers, add bought-parts BOM
    Bureaus price kits by bounding box. Stacking the gearbox parts with
    2 mm gaps and snap-off pillars cuts kit boxes 40-60% versus flat sprue
    trees. Adds bom/bom.csv and the generated BOM.md, sizes dowel pins to
    stock lengths, and checks pin engagement in the gearbox layout.
    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
    [base.step, bom.csv, forearm.step, grip_assembly.step, gripper_finger.step, gripper_jaw.step, gripper_palm.step, gripper_pinion.step]
2026-10-27 Build guide, technical drawings, and fit fixes found while writing them
    - docs/BUILD.md: gearbox, arm, gripper, wiring and driver setup steps
    - cad/drawings.py: gearbox half sections with parts lists, arm and gripper
    views, all generated from the CAD; cad/exploded.py: exploded gearbox renders
    - Housings sink the motor screw heads (they hit the discs before)
    - Pods deepened so the MKS driver boards fit behind every motor; wrist
    lengthened to 128 mm and upper arm shortened to 187 mm so J6 clears J5,
    reach stays 500 mm; wrist link bone rerouted to clear the yoke
    - Every hub bolt now has a straight driver path: through-counterbores on
    the side hubs, internal tool channels on the J1 and J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
    [base.step, bom.csv, forearm.step, forearm.stl, grip_assembly.step, gripper_finger.step, gripper_finger.stl, gripper_jaw.step]
2026-10-27 Move gearbox through-bolts inboard so they don't break out of the housing
    The six M3 bolts sat 0.3 mm from the housing's outer face (the wrist ones
    broke through, and the cap counterbores notched the rim). They now sit
    just outside the disc bore, between ring pins, and check_pins asserts the
    pin web and rim skin. Wrist housing wall 4 -> 5.5 mm (OD 59 -> 62).
    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
    [base.step, base.stl, forearm.step, forearm.stl, grip_assembly.step, gripper_finger.step, gripper_jaw.step, gripper_palm.step]
2026-10-27 Cost pass 2: stepped gearbox caps, lighter housing floors
    The cap keeps full height only round the output bearing; the clamping
    ring outside it drops to 4.5-5 mm and the through-bolt heads sit on it,
    so the counterbores go. J1/J3 housing floors are pocketed outside the
    motor flange. Gearbox kit volume 726 -> 686 cm3. Socket insert holes
    deepened to 9 mm to suit the bolt lengths.
    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
    [base.step, forearm.step, forearm.stl, grip_assembly.step, gripper_finger.step, gripper_jaw.step, gripper_palm.step, gripper_pinion.step]
2026-10-27 FDM edition, cheaper bought parts, gripper on steel rods
    - build.py --fdm writes exports/fdm: FDM fits (params.Process), solid links with
    internal cable tunnels and driver bays, STLs pre-oriented for printing, a fit-test
    coupon, filament estimate and printer-size check per part (~2.1 kg filament)
    - docs/FDM.md: materials, print settings, weight and cost comparison
    - Bought parts $603 -> $492: cheaper bearings, clone CAN adapter, generic PSU
    - Gripper jaws ride two 6 mm rods on LM6UU bearings instead of an MGN7 rail; the old
    carriages ran off the rail at full opening. Pinion now turns with the jaws in the model
    Claude-Session: htt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
    [base.step, base.stl, bom.csv, fit_coupon.step, fit_coupon.stl, forearm.step, forearm.stl, grip_assembly.step]
2026-10-27 Fix FDM bed flats (only one quadrant was shaved) and build guide numbers
    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
    [base.step, fit_coupon.step, forearm.step, forearm.stl, gripper_finger.step, gripper_frame.step, gripper_jaw.step, gripper_palm.step]
2026-10-27 URDF generated from the CAD, with masses and inertias from every part
    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
    [base_link.stl, forearm.stl, grip.urdf, jaw_a.stl, jaw_b.stl, tool.stl, turret.stl, upper_arm.stl]
2026-10-27 FDM: check parts against a 180 mm A1 mini bed
    The forearm and upper arm are the two parts to have printed elsewhere;
    everything else fits an A1 mini.
    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
    [printed_parts.csv]
2026-10-28 Add a wrist camera for vision
    Arducam UB0234 (1080p USB, 105 deg M12 lens) in a printed cradle on the
    gripper's -y rail, tilted 15 deg toward the tool axis, with a 5 V LED light.
    New docs/VISION.md covers the build, the cable splice, focusing, lens and
    hand-eye calibration, AprilTag registration and the unload loop. The URDF
    gains a wrist_camera_optical frame; BOM +$47 (bought parts $539).
    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
    [base.step, bom.csv, fit_coupon.step, forearm.step, grip.urdf, grip_assembly.step, gripper_camera_mount.step, gripper_camera_mount.stl]
2026-10-28 BUILD: nine SLS shells now the camera cradle is one
    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
2026-10-28 Generative redesign of the structural links (loadpath)
    generative/chain.py writes a topology optimization study per link from
    params.py: a bolt ring on the joint below and a socket for the drive
    above, with the drives, motors, driver boards, hub-bolt access and swing
    clearances kept out. Loads come from statics over the URDF (1 kg payload,
    reaching out, 1.5x dynamic) plus each joint's rated torque and a side
    push; link masses are fed back and the chain re-optimized.
    Two iterations: the five printed links go from 761 g to 572 g (-25%),
    each verified under identical loads; every generated link is stiffer in
    every case, and the upper arm, forearm and wrist link go from SF ~0.5 at
    their joint's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
    [forearm.stl, turret.stl, upper_arm.stl, wrist_link.stl, wrist_yoke.stl]
2026-10-28 Architecture trade study: wrist motors inboard, belt wrist, J2 counterbalance
    generative/architecture.py: static J2/J3 torques reaching out with 1 kg,
    x1.5, for the as-built arm, the generated links, wrist motors moved to the
    elbow with belt reductions, and a J2 spring counterbalance. With all three
    J2 needs 8.8 N·m against the 13 N·m of the J1/J3 drive, so the NEMA 23
    shoulder drive can go.
2026-10-28 Trade study: bus servos at the wrist beat a belt-driven wrist
    Feetech STS3215 (rolls) and STS3250 (pitch) at the wrist joints instead
    of stepper + driver + printed cycloidal take ~0.9 kg off the far end,
    more than moving the motors to the elbow did, with no belts through
    rotating joints. With a J2 spring the shoulder needs 8.4 N·m and fits the
    13 N·m J1/J3 drive.
2026-10-28 generative: v0.3 architecture (spring-balanced J2, bus-servo wrist) with regenerated links
    [forearm.stl, turret.stl, upper_arm.stl, wrist_link.stl, wrist_yoke.stl]
2026-10-28 generative: open servo holders (collar + pad), stress-map sims of the v0.3 links
    [forearm.stl, wrist_link.stl, wrist_yoke.stl]
2026-10-28 generative: screw-boss servo mounts, regenerated wrist at 2x, three-finger soft hand concept
    [finger.stl, forearm.stl, nail.stl, palm.stl, turret.stl, wrist_link.stl, wrist_yoke.stl]
2026-10-28 generative: palm with interface-only finger mounts, nail pinned for scraping loads, finger as compliant mechanism (experimental)
    [finger-mech.stl, finger-wrap.stl, palm.stl]
2026-10-28 generative: upper arm regenerated at 2x with the fine-grid confirm (watertight)
    [upper_arm.stl]
2026-10-28 generative: servo links redrawn with rounded boundaries, boss fillets and clear screw seats; remesh command; density fields saved
    [finger-wrap.stl, forearm.stl, wrist_link.stl, wrist_yoke.stl]
2026-10-28 generative: servo links re-meshed with 3 mm boss fillets
    [forearm.stl, wrist_link.stl, wrist_yoke.stl]
2026-10-28 generative: print-ready FDM PETG wrist yoke (oriented for the bed)
    [grip-wrist-yoke-PETG-FDM-v3.stl]
2026-10-29 generative: point at the published loadpath repository
    [forearm.stl, wrist_link.stl, wrist_yoke.stl]
